Siggeaxe/DIY_Quadcopter/Quadcopter drone communication protocol.docx

# Quadcopter drone communication protocol

Each message from slave to master consists of two bytes where one decides the function

0b XXXX XXXX XXXX XXXX

Command byte Value Byte

Commands list

Command | Variable | Description
0000 0001 | PCOM | Lift power is set according to map(byte2 0, 256, 900, 2200);
0000 0010 | ref_x | Rotation around x axis (-128 128) degrees/s
0000 0011 | ref_y | Rotation around y axis (-128 128) degrees/s
0000 0100 | force_zero | Forces ref_x and ref_y to zero if byte2 is 1.
