Siggeaxe/DIY_Quadcopter/länkar/Modelering och Systemidentifiering/Autonomous Drone Racing Project Course.pdf

## Autonomous Drone Racing Project Course

## Quadrotor Introduction Handout

## 1. Overview

Quadrotors are flying vehicles that have a rigid frame with four independently controlled motors, as shown in Figure 1. By changing the motor speeds, we can make the quadrotor perform different maneuvers such as moving towards a specified position or performing a flip. As compared to conventional fixed-wing flying vehicles, quadrotors are more compact and can perform vertical takeoff and landing, which makes them suitable for a wide range of applications. Some example applications include search and rescue, industrial inspection, and entertainment.

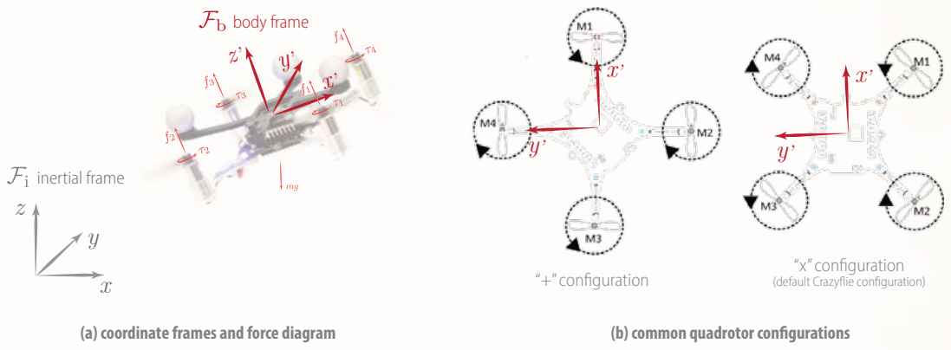
[picture p17: figure]

Figure 1: Illustration of a quadrotor: (a) A quadrotor is a flying vehicle equipped with a rigid frame and four motors that are controlled independently. Typically, two of the motors spin in the clockwise direction and two spin in the counterclockwise direction. Each motor generates a thrust f
i aligning with the axis of rotation and a torque τi about its axis of rotation. Different quadrotor maneuvers are realized by varying the speeds of the four independently controlled motors. As an example, hovering motion can be achieved by setting the motor speeds such that f
i = mg/4 for all
i = {1, 2, 3, 4}, where m is the mass of the quadrotor and g is the acceleration due to gravitation. Generally, the translational acceleration of the quadrotor is determined by the attitude of the quadrotor, which is in turn controlled via the individual motors. There are two essential coordinate frames pertinent to every quadrotor estimation, planning, and control framework: (i) the inertial frame or the “world frame” and (ii) the body frame that is fixed to the quadrotor. The translation and rotation of the body frame relative to the world frame together characterize the pose of the quadrotor that is estimated based on sensor measurements and is used for planning and control. (b) There are two common configurations or body frame conventions for a quadrotor. The “+” configuration aligns have its x and y axes aligned with the frame, while the “×” configuration offsets by 45◦
. From a mathematical point of view, there are no major differences between the two configurations. Practically, the latter could be preferable for certain cases (e.g., mounting a front-facing camera below the frame. The Crazyflie platform used in this course follows the “×” configuration for its onboard estimation and control algorithm implementations.

## 2. Quadrotor Dynamics

The motion of a quadrotor is fully driven by the four motors—two spinning clockwise and two spinning counterclockwise, as illustrated in Figure 1. Quadrotors are underactuated systems as it has six degrees of freedom but only four independent inputs. We briefly summarize the dynamics

Page 1 of 11 pages | last revised: April 9, 2024

of a quadrotor system in this section, which are divided into two parts: (i) motor dynamics and (ii) rigid body dynamics.

### 2.1 Motor Dynamics

Each motor is equipped with a propeller that is firmly attached to the motor’s shaft. As the motor rotates, the propeller produces a force, known as thrust fi
, that is aligned with the motor’s axis of rotation, as well as a reaction torque τi about the axis of rotation. The thrust and torque produced by each motor are determined by their respective characteristic curves, which are often identified empirically. A basic motor model takes the following form:

fi = ctΩ²
i
, | (1)

τi = cdΩ²

i + JmΩ˙
i
| {z }
inertia
moment
, | (2)

where Ωi denotes the motor rotational speed represented as revolutions per minute (RPM), ct and cd respectively are the lift and drag coefficients associated with the particular propeller, and Jm is the inertia coefficient. The inertia moment of the motor is often negligible; both motor thrust and torque are roughly proportional to Ω²
i

. The lift and drag coefficients of the default Crazyflie setup are 3.1582 × 10⁻¹⁰ N/RPM² and 7.9379 × 10⁻¹² Nm/RPM²
, respectively.
How do we regulate the speed of the motor? This is controlled by the pulse-width modulation (PWM). Intuitively, the PWM controls the average power delivered to the motor by varying the duration and frequency of switching on/off the voltage supply. For the DC motor used on the Crazyflie platform, we can relate the PWM signal µ and the RMP as follows:
Ωi = αµi + β, | (3)

where the PWM signal µi

is a 16-bit number between 0 and 65535, and α = 0.2685 and β = 4070.3 are two constants specific to the motor.

### 2.2 Rigid Body Dynamics

The motor thrust and torque collectively generate thrust forces and torques that enable different quadrotor maneuvers. The collective thrust generated by the motors is always aligned with the body z

′
-axis:

F =

4
∑

i=1

fi = ct

4
∑

i=1

Ω²
i
. | (4)

Following the “×” configuration defined in Figure 1, we can express the body torques as a function of the motor rotation rates as follows:

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
−cτxy | −cτxy | +cτxy | +cτxy
−cτxy | +cτxy | +cτxy | −cτxy
−cτz | +cτz | −cτz | +cτz

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
where cτxy = lct/

√
2 and cτz = cd and l is the arm length of the quadrotor (i.e., the distance from the centre to the motor shaft). Note that the reaction torque generated by individual motors is opposite to their rotation direction (Figure 1).
Page 2 of 11 pages | last revised: April 9, 2024

The collective thrust F and the body torque τ are the inputs to the rigid body dynamics of the quadrotor system. A continuous-time model of the quadrotor is

p˙ = v, | (6)
mv˙ = mg + Rf, | (7)
R˙ = RS(ω), | (8)
Jω˙ = Jω × ω + τ, | (9)

where p = [px, py, pz]

T and v = [vx, vy, vz]

T are the translational position and velocity of the center of mass (COM) of the quadrotor, R

i
b

is the rotation matrix from the body frame to the inertial frame, ω = [p, q,r]

T
is the body angular velocity, m is the mass of the quadrotor, J = diag(Jxx, Jyy, Jzz) is the inertia matrix, S(·) denotes the skew-symmetric matrix mapping of a vector, and g = [0, 0, −g]

T
is the gravitational force vector.
Note that, there are different ways of parametrizing the orientation of a quadrotor (or a rigid body in general). Euler angles and quaternions are two common parameterizations. The former is easier to interpret intuitively but has singularity issues, while the latter is easier to work with computationally but is an over-parametrization scheme. To facilitate the controller design discussion in the following section, we briefly review how the rotational dynamics can be expressed in terms of Euler angles; one could similarly express the rotational dynamics in quaternions.
The Euler angles refer to the roll ϕ, pitch θ, and yaw ψ angles, which respectively correspond to rotations about the x, y, and z axes. One can uniquely define a rotation matrix through these angles following a specified sequence of rotation. As an example, a Z-Y-X sequence (i.e., first rotating about the z axis by ψ, then about the y axis by θ, and lastly about the x axis by ϕ) results in the following rotation matrix from the inertial frame to the body frame:

R

b
i =
cos θ cos ψ | cos θ sin ψ | − sin θ
sin ϕ sin θ cos ψ − cos ϕ sin ψ sin ϕ sin θ sin ψ + cos ϕ cos ψ sin ϕ cos θ cos ϕ sin θ cos ψ + sin ϕ sin ψ cos ϕ sin θ sin ψ − sin ϕ cos ψ cos ϕ cos θ
- . (10)

Note that, the rotation matrix from the body frame to the inertial frame is R

i
b = (R

b
i

)

−1 = (R
b
i

)

T
We can relate the body angular velocity and the time-derivatives of Euler angles as follows:

p
q
r
- =
1 | 0 | − sin θ
0 | cos ϕ | sin ϕ cos θ
0 − sin ϕ cos ϕ cos θ
| | {z | }
W1

ϕ˙
˙θ
ψ˙

|{z}
ψ˙
= W1 ψ˙ , | (11)

ϕ˙
˙θ
ψ˙
- =
1 | sin ϕ tan θ | cos ϕ tan θ
0 | cos ϕ | − sin ϕ
0 sin ϕ/ cos θ cos ϕ/ cos θ
| | {z | }
W2

p
q
r

|{z}
ω

= W2 ω for θ ̸=

π
2
, | (12)

The rotational dynamics can then be written as

ψ¨ = W˙

2 ω + W2 ω˙ = W˙
2 ω + W2 J

−1
(Jω × ω + τ), | (13)

where ψ¨ = [ϕ¨,

¨θ, ψ¨]
T and ω = W1 ψ˙ .
Let u = [F, τx
′ , τy

′ , τz

′]

T be the input and x = [p

T
, v

T

, ψT

, ψ˙ T
]

T be the state. We can write the translational and rotational dynamics in the state-space model form:

x˙ = f(x, u). | (14)
Page 3 of 11 pages | last revised: April 9, 2024

One could also define u as the motor rotation rates [Ω²
1

, Ω²
2

, Ω²
3

, Ω²
4

]

T or the PWM signals
[µ
2/1, µ

2/2, µ

2/3, µ

2/4]

T
if the lower-level motor dynamics is of interest for the particular problem. The parameters for the Crazyflie platform are summarized in Table 1.

Table 1: Parameters of the Crazyflie platform.

mass (m) | 0.27 kg
arm length (l) | 42.0 × 10⁻³ m
moment of inertia (Jxx, Jyy, Jzz) | (1.395 × 10⁻⁵

, 1.436 × 10⁻⁵

, 2.173 × 10⁻⁵
) kg m²

### 2.3 So, how do things fit together?

The PWM of individual motors regulates their rotational speeds, and the motor RPMs determine the thrust and reaction torque produced. Variations in thrust and torque among individual motors result in body torques, influencing the quadrotor’s attitude. The attitude and collective thrust of the quadrotor together determine the direction and magnitude of translational acceleration, respectively, which induces translational motion.

## 3. Quadrotor Control

We consider a trajectory-tracking problem and present a typical controller to demonstrate the idea. The trajectory consists of [pdes, ψdes] and is often given by a trajectory generator to realize a higher-level objective (e.g., navigating through an environment).
The controller design of the quadrotor system addresses the question: how do we go from the position trajectory to the low-level motor commands such that the COM of the quadrotor accurately follows the desired trajectory? One approach is to break the problem into three subproblems, resulting in a nested control architecture (Figure 2). There are three key components in the overall control system:
1. High-level position control: Mapping desired position (and optionally yaw) trajectories to desired attitude (i.e., roll, pitch, and yaw angles) and desired collective thrust
2. Mid-level attitude control: Mapping desired attitude to desired body torques
3. Low-level motor control: Computing motor speeds based on desired body torques and desired collective thrust
A default controller equipped onboard the Crazyflie is the Mellinger controller (Mellinger and Kumar, 2011). We summarize the key equations here; you are encouraged to check out the onboard implementation of the Crazyflie platform to better understand how it works.

### 3.1 Position Control

The desired collective thrust and attitude are computed to drive the position error of the quadrotor to zero. We define the position error as

ep = p − pdes. | (15)

A possible way for computing the desired translational acceleration in the inertial frame is based on a PD control law:

fdes = −kpep − kde˙ p
| | {z | }
| feedback
− | mg
|{z}
feedforward
, | (16)
Page 4 of 11 pages | last revised: April 9, 2024

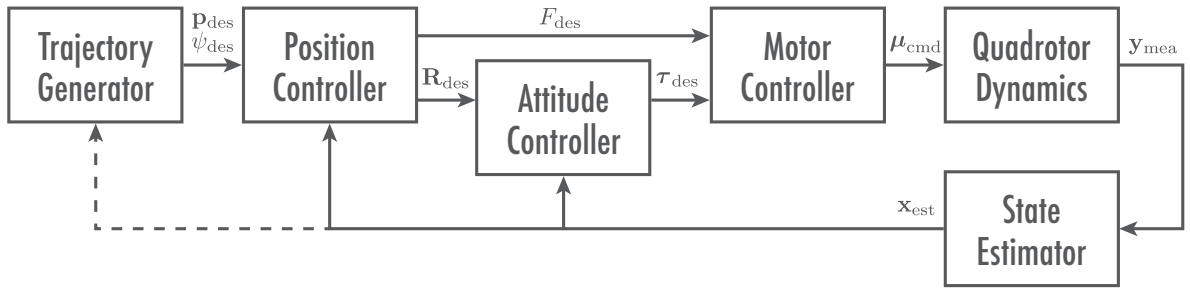
[picture p18: figure]
Trajectory Generator; Position; Controller; Attitude; State Estimator; Quadrotor Dynamics; Motor Controller

Figure 2: Block diagram of a typical quadrotor system: The trajectory generator provides the desired position and yaw trajectories to fulfill a high-level task. The controller can be decomposed into three levels: (i) the position controller computes the desired collective thrust and attitude to minimize the position and yaw error, (ii) the attitude controller computes the desired body torques based on the attitude error, and (iii) the motor controller then computes motor commands to realize the desired collective thrust and body torques. A state estimator is used to bookkeep the sensor measurements (e.g., IMU measurements, motion capture system measurements, ultra-wideband signals, RGB-D camera images) and provides consistent estimates of the quadrotor’s full state that are fed back to the controllers and optionally the trajectory generator.

where kp > 0 and kd > 0 are the PD gains. The desired collective thrust (defining the desired magnitude of acceleration) is the projection of fdes to the body z

′ axis:

Fdes = (fdes)

T
z

′
(17)

The desired attitude (defining the desired direction of acceleration and accounting for the desired yaw angle) can be written as a rotation matrix as follows:

Rdes =

x

′
des y

′
des z

′
des
, | (18)

where

z

′
des =

fdes
||fdes||, | (19)

y

′
des =

z

′
des × ndes
||z

′

des × ndes|| with ndes =

cos ψdes
sin ψdes
0
- , and | (20)

x

′
des = y

′
des × z

′
des. | (21)

### 3.2 Attitude Control

The attitude controller computes the desired moments to bring the actual rotation Ract close to the desired rotation Rdes. The orientation error is defined as

εR =

1
2
R

T
desRact − R

T

actRdes∨
, | (22)
where “∨” is the vee operator that maps elements of SO(3) to R³ | . The angular velocity error is
defined as follows:
εω = ωact − ωdes. | (23)

Note that, the desired angular velocity ωdes should be defined such that εω is consistent with the rotation error εR. We can alternatively set it to zero, but this would typically lead to poorer tracking performance. The desired body torques can be similarly computed based on a PD scheme:

τdes = −kRεR − kωεω, | (24)

where kR and kω are diagonal matrices with positive gains.

Page 5 of 11 pages | last revised: April 9, 2024

### 3.3 Motor Control

Given Fdes and τdes, we can compute the corresponding desired motor rates. This step is really reversing the maps defined in (4) and (5) by solving for Ωi
. The desired motor rates for given Fdes and τdes can be computed as follows:

Ω²
1,des
Ω²
2,des
Ω²
3,des
Ω²
4,des

=

1
4

1/ct | −1/cτxy | −1/cτxy | −1/cτz
1/ct | −1/cτxy | 1/cτxy | 1/cτz
1/ct | 1/cτxy | 1/cτxy | −1/cτz
1/ct | 1/cτxy | −1/cτxy | 1/cτz

Fdes

τdes
, | (25)

where cτxy = lct/

√
2 and cτz = cd
The PWMs of the individual motors are computed by inverting the map in (3):

µi,cmd = α

−1
(Ωi,des − β). | (26)

## 4. Smooth Trajectory Generation

The trajectories are often required to be sufficiently smooth and satisfy a set of constraints to be feasible for a quadrotor to track. There are various methods to generate trajectories for a quadrotor system; we present one position trajectory generation formulation that is adapted based on (Mellinger and Kumar, 2011). The desired yaw angle can be often defined in a decoupled manner. For a quadrotor equipped with an onboard camera for mapping the environment, the desired yaw angle could be, for instance, designed to maximize the information gain.
The desired position trajectories px,des, py,des, and pz,des are respectively parametrized as splines or piecewise polynomials. The minimum-derivative trajectory optimization problem is to minimize the objective:

min Z t1

t0

||T

(r)
1

(t)||²
dt +

Z t2

t1

||T

(r)
2

(t)||²
dt + · · · +

# Z tS

tS−1

||T

(r)
S

(t)||²
dt
| | {z | }
| ≜J

(27)

subjected to the spline continuity constraints (i.e., continuity of the value and higher derivatives at endpoints), where Ts(t) = ∑

N
n=0 ps,nt

n
for s = {1, 2, ..., S} are S segments of Nth-order polynomials composing the spline, and the superscript (r) denotes the rth time-derivative. In the discussion below, following derivations similar to (Richter et al., 2016; Mellinger and Kumar, 2011), we show that this objective can be written in a quadratic form and the overall optimization can be formulated as a quadratic program (QP).

### 4.1 Objective Function in Quadratic Form

We first show that the minimum-derivative objective associated with each polynomial segment Ts(t) can be written in the following quadratic form:

Js =

# Z ts

ts−1

||T

(r)
s (t)||²
dt = p

T
s Qsps
, | (28)

where Js denotes the objective function associated with the sth polynomial, ps are the coefficients of the polynomial in ascending order, and Qs ∈ R⁽N+1)×(N+1)
is the Hessian to be derived. Note that the objective function for the overall spline can be written as

J =

S
∑

s=1

p

T
s Qsps = P
TQP, | (29)
Page 6 of 11 pages | last revised: April 9, 2024

where P = [p

T
1

, p

T
2

, ..., p

T
S

]

T
is the stack of the coefficients for all S polynomial segments and Q = blockdiag(Q1, Q2, ..., QS) is the augmentation of Hessians. In the derivations below, we focus on the objective function for one of the segments Js

▷ Objective function: The objective function is

Js =

# Z ts

ts−1

||T

(r)
s (t)||²
dt =

# Z ts

ts−1

d

r
dtr

N
∑

n=0

ps,nt

n

2
dt =

# Z ts

ts−1

I(t) dt, | (30)

where I(t) =

d

r
dtr ∑

N
n=0 ps,nt

n

2
=
d

r
dtr ∑

N
n=0 ps,nt

n

2
denotes the integrand in the minimum-derivative objective function.
▷ Derivative: The rth derivative of the polynomial can be written as

d

r
dtr

N
∑

n=0

ps,nt

n =

N
∑n=r
ps,n [n(n − 1)· · ·(n − r + 1)] t

n−r =

N
∑n=r

"
ps,n

r−1
∏m=0
n − m

!
t

n−r

. (31)

Note that the objective function drops the dependencies on the first r − 1 coefficients; these coefficients play a role only in the constraints. In other words, the magnitudes of the higher-order coefficients are penalized with this objective, which enforces smoothness.
▷ Square of polynomials: After obtaining the rth derivative, the next operation in (30) to consider is the square of the polynomial (derivative, in fact). There are different ways of calculating the square of polynomials (e.g., in (Richter et al., 2016), it is written as a convolution and the Hessian is then calculated by taking derivatives of the convolution). Here, we try to take a different approach, where we write out the quadratic form directly (without the need to take derivatives twice afterwards).
We first note that the square of a polynomial ρ(ξ) = ∑

K
k=0

θkξ

k
(swapped notations to Greek letters to avoid confusion) can be written as

ρ(ξ) =

K
∑

k=0

θkξ

k

!2
(32)

=

θ0 | θ1 | · · · θK

ξ

0
ξ

1
- · · ξ

K
ξ

1
- · · | ξ
K | ξ

K+1

ξ

K ξ

K+1
- · · ξ

2K

| | {z | }
≜ Ξ

θ0
θ1
θK

| {z }
≜ θ

(33)

= θ

TΞθ. | (34)

For our case, where the square is raised to the derivative of the polynomial, we can apply the above quadratic form translation by only considering the elements in the bottom square block from indices r to N (since the summation is from n = r to n = N in (31) and the coefficient vector contains the coefficients from n = 0 to n = N).
Here are the details. We write the square of the polynomial in (31) (which is also the integrand
Page 7 of 11 pages | last revised: April 9, 2024

of the objective function in (30)) as

I(t) =

N
∑n=r

"
ps,n

r−1
∏m=0
n − m

!
t

n−r

#!2

(35)

= pe

T

t

0
t

1
- · · t

N−r
t

1
- · · t

N−r
t

N−r+1

t

N−r
t

N−r+1
- · · t

2(N−r)

| | {z | }
| ≜ Me (t)
pe, | (36)

where pe =

h
ps,r
∏

r−1
m=0

r − m

, ps,r+1
∏

r−1
m=0

r + 1 − m

, ..., ps,N
∏

r−1
m=0 N − m

iT
. Note
that the series multiplied by the polynomial coefficients are constants; for convenience, we define

c(q) =

r−1
∏m=0
q − m, | (37)

where r is the order of the derivative we are taking in (31). We define a matrix C ∈
R⁽N−r+1)×(N+1)

C =

0 · · · 0 | c(r) | 0 | · · · | 0
0 · · · 0 | 0 | c(r + 1) · · · | 0
0 · · · 0 | 0 | 0 | · · · c(N)

=

h
0(N−r+1)×r Ce

i
, | (38)

and rewrite (36) as

I(t) = p

T
s C
TMe (t)Cps | (39)

= p

T
s M(t)ps
, | (40)

where the substitution pe = Cps

is made and M(t) = C

TMe (t)C.

▷ Integration: Given the quadratic form of the integrand in (40), we can then evaluate the integration in the minimum-derivative objective function in (30) between two given times
ts−1 and ts

. We note that, in the quadratic form in (40), the only time-dependent terms come from M(t), which are summarized in the matrix Me (t). The operations of the quadratic form are equivalent to a set of summations over the non-zero entries of M(t) which comes down to the elements of Me (t). The integration of the quadratic expression I(t) can be then evaluated and written as below

Js =

# Z ts

ts−1

I(t) dt | (41)

=

# Z ts

ts−1

p

T
s C
TMe (t)Cps dt | (42)

= p

T
s Qsps
, | (43)

where

Qs = C

TQesC =

"
0r×r | 0r×(N−r+1)
0(N−r+1)×r | CeTQesCe
, | (44)
Page 8 of 11 pages | last revised: April 9, 2024

### 0 are zero matrices with dimensions indicated by the corresponding subscripts, and Qes

contains the element-wise integrations of Me (t) from ts−1 to ts

Qes =

ts − ts−1

t

2
s−t

2
s−1
2
- · ·

t

N−r+1
s −t

N−r+1
s−1
N−r+1
t

2
s−t

2
s−1
2
- · ·

t

N−r+1
s −t

N−r+1
s−1
N−r+1

t

N−r+2
s −t

N−r+2
s−1
N−r+2

t

N−r+1
s −t

N−r+1
s−1
N−r+1

t

N−r+2
s −t

N−r+2
s−1
N−r+2
- · ·

t

2(N−r)+1
s | −t

2(N−r)+1
s−1
2(N−r)+1

. | (45)

Continuity as Equality Constraints. The position trajectories are splines and C

r
continuities can
be enforced at the endpoints to ensure feasibility for tracking. Similar to the objective function derivation, we consider one polynomial segment indexed with s. The rth derivative of the polynomial at the endpoints can be written as

Asrtps =

0 · · · 0 c(r) c(r + 1)t · · · c(N)t

N−r
ps
, | (46)

where t = {ts−1, ts} is the time at the end point. A side note on the notation: the subscripts of the matrix A are s denoting the segment index, r denoting the rth derivative of the polynomial, and t denoting the starting or the terminal endpoint. For each polynomial segment s, we can encode the continuity constraints as follows:

Asps = bs
, | (47)

where

As =

As0ts−1
As1ts−1

Asrmaxts−1
As0ts
As1ts

Asrmaxts

and bs =

T

(0)
s (ts−1)
T

(1)
s (ts−1)
T

(rmax)
s (ts−1)
T

(0)
s (ts)
T

(1)
s (ts)
T

(rmax)
s (ts)

. | (48)

### 4.2 The Smooth Trajectory Generation QP

The minimum-derivative trajectory optimization problem is overall a QP that can be solved efficiently:

min
p

S
∑

s=1

p

T
s Qsps
subject to | Asps = bs | for s = {1, 2, ..., S},

(49)

where ps contains the coefficients of the sth polynomial segment (in the ascending order), Qs is the
Hessian matrix defined in (44), and the pairs (As
| | , bs) set continuity constraints on the endpoints
of the polynomials composing the spline. One may optionally introduce additional constraints on the spline trajectories or their higher derivatives to account for the physical constraints of the quadrotor and the operating environment.
Page 9 of 11 pages | last revised: April 9, 2024

## 5. Further Reading

Drone Racing

[1] E. Kaufmann, L. Bauersfeld, A. Loquercio, M. Muller, V. Koltun, and D. Scaramuzza, ¨ “Champion-level drone racing using deep reinforcement learning,” Nature, vol. 620, no. 7976, pp. 982–987, 2023. [pdf] (https://www.nature.com/articles/s41586-023-06419-4)
[2] D. Hanover, A. Loquercio, L. Bauersfeld, A. Romero, R. Penicka, Y. Song, G. Cioffi,
E. Kaufmann, and D. Scaramuzza, “Autonomous drone racing: A survey,” 2023. [pdf] (https://rpg.ifi.uzh.ch/docs/Arxiv24_Romero.pdf)

General Quadrotor Modeling, Planning, and Control

[1] D. Mellinger and V. Kumar, “Minimum snap trajectory generation and control for quadrotors,” in Proc. of the IEEE International Conference on Robotics and Automation (ICRA), 2011, pp. 2520–2525. [pdf] (https://1drv.ms/b/s!AnKwjI86SDWmhboxcIjst3bHjY3qaQ?e=b567Zp)
[2] C. Powers, D. Mellinger, and V. Kumar, “Quadrotor kinematics and dynamics,” in Handbook of Unmanned Aerial Vehicles. Springer, 2015, ch. 16, pp. 307–327. [pdf] (https://1drv.ms/b/s!AnKwjI86SDWmhboyNGuAEXuU2Q5ODQ?e=nucRyh)

Crazyflie Modeling, Planning, and Control

[1] C. Luis and J. L. Ny, “Design of a trajectory tracking controller for a nanoquadcopter,” arXiv preprint arXiv:1608.05786, 2016, Technical Report, Mobile Robotics and Autonomous Systems Laboratory, Polytechnique Montreal. [pdf] (https://arxiv.org/pdf/1608.05786.pdf)
[2] C. E. Luis, M. Vukosavljev, and A. P. Schoellig, “Online trajectory generation with distributed model predictive control for multi-robot motion planning,” IEEE Robotics and Automation Letters (RA-L), vol. 5, no. 2, pp. 604–611, 2020. [pdf] (https://arxiv.org/pdf/1909.05150.pdf)
[3] S. Teetaert, W. Zhao, N. Xinyuan, H. Zahir, H. Leong, M. Hidalgo, G. Puga, T. Lorente,
N. Espinosa, J. A. D. Carrasco et al., “A remote sim2real aerial competition: Fostering reproducibility and solutions’ diversity in robotics challenges,” arXiv preprint arXiv:2308.16743, 2023, IROS 2022 Safe Robot Learning Competition. [pdf] (https://arxiv.org/pdf/2308.16743.pdf)

Learning and Adaptation

[1] K. Pereida and A. P. Schoellig, “Adaptive model predictive control for high-accuracy trajectory tracking in changing conditions,” in Proc. of the IEEE/RSJ International Conference on Intelligent Robots and Systems (IROS), 2018, pp. 7831–7837. [pdf] (https://arxiv.org/pdf/1807.05290.pdf)
[2] Z. Wu, S. Cheng, P. Zhao, A. Gahlawat, K. A. Ackerman, A. Lakshmanan, C. Yang, J. Yu, and N. Hovakimyan, “L1 quad: L1 adaptive augmentation of geometric control for agile quadrotors with performance guarantees,” arXiv preprint arXiv:2302.07208, 2023. [pdf] (https://arxiv.org/pdf/2302.07208.pdf)
[3] A. P. Schoellig, F. L. Mueller, and R. D’andrea, “Optimization-based iterative learning for precise quadrocopter trajectory tracking,” Autonomous Robots, vol. 33, pp. 103–127, 2012. [pdf] (https://www.research-collection.ethz.ch/bitstream/handle/20.500.11850/50326/2/10514_2012_Article_9283.pdf)
[4] M. Greeff and A. P. Schoellig, “Flatness-based model predictive control for quadrotor trajectory tracking,” in 2018 IEEE/RSJ International Conference on Intelligent Robots and Systems (IROS), 2018, pp. 6740–6745. [pdf] (https://www.dynsyslab.org/wp-content/papercite-data/pdf/greeff-iros18.pdf)
[5] S. Zhou, M. K. Helwa, and A. P. Schoellig, “Deep neural networks as add-on modules for enhancing robot performance in impromptu trajectory tracking,” The International Journal of Robotics Research, vol. 39, no. 12, pp. 1397–1418, 2020. [pdf] (https://www.dynsyslab.org/wp-content/papercite-data/pdf/zhou-ijrr20.pdf)
Page 10 of 11 pages | last revised: April 9, 2024

## References

D. Mellinger and V. Kumar, “Minimum snap trajectory generation and control for quadrotors,” in Proc. of the IEEE International Conference on Robotics and Automation (ICRA), 2011, pp. 2520–2525.
C. Richter, A. Bry, and N. Roy, “Polynomial trajectory planning for aggressive quadrotor flight in dense indoor environments,” in Robotics Research. Springer, 2016, pp. 649–666.
E. Kaufmann, L. Bauersfeld, A. Loquercio, M. Muller, V. Koltun, and D. Scaramuzza, “Champion- ¨ level drone racing using deep reinforcement learning,” Nature, vol. 620, no. 7976, pp. 982–987, 2023.
D. Hanover, A. Loquercio, L. Bauersfeld, A. Romero, R. Penicka, Y. Song, G. Cioffi, E. Kaufmann, and D. Scaramuzza, “Autonomous drone racing: A survey,” 2023.
C. Powers, D. Mellinger, and V. Kumar, “Quadrotor kinematics and dynamics,” in Handbook of Unmanned Aerial Vehicles. Springer, 2015, ch. 16, pp. 307–327.
C. Luis and J. L. Ny, “Design of a trajectory tracking controller for a nanoquadcopter,” arXiv preprint arXiv:1608.05786, 2016, Technical Report, Mobile Robotics and Autonomous Systems Laboratory, Polytechnique Montreal.
C. E. Luis, M. Vukosavljev, and A. P. Schoellig, “Online trajectory generation with distributed model predictive control for multi-robot motion planning,” IEEE Robotics and Automation Letters (RA-L), vol. 5, no. 2, pp. 604–611, 2020.
S. Teetaert, W. Zhao, N. Xinyuan, H. Zahir, H. Leong, M. Hidalgo, G. Puga, T. Lorente, N. Espinosa,
J. A. D. Carrasco et al., “A remote sim2real aerial competition: Fostering reproducibility and solutions’ diversity in robotics challenges,” arXiv preprint arXiv:2308.16743, 2023, IROS 2022 Safe Robot Learning Competition.
K. Pereida and A. P. Schoellig, “Adaptive model predictive control for high-accuracy trajectory tracking in changing conditions,” in Proc. of the IEEE/RSJ International Conference on Intelligent Robots and Systems (IROS), 2018, pp. 7831–7837.
Z. Wu, S. Cheng, P. Zhao, A. Gahlawat, K. A. Ackerman, A. Lakshmanan, C. Yang, J. Yu, and
N. Hovakimyan, “L1 quad: L1 adaptive augmentation of geometric control for agile quadrotors with performance guarantees,” arXiv preprint arXiv:2302.07208, 2023.
A. P. Schoellig, F. L. Mueller, and R. D’andrea, “Optimization-based iterative learning for precise quadrocopter trajectory tracking,” Autonomous Robots, vol. 33, pp. 103–127, 2012.
M. Greeff and A. P. Schoellig, “Flatness-based model predictive control for quadrotor trajectory tracking,” in 2018 IEEE/RSJ International Conference on Intelligent Robots and Systems (IROS), 2018, pp. 6740–6745.
S. Zhou, M. K. Helwa, and A. P. Schoellig, “Deep neural networks as add-on modules for enhancing robot performance in impromptu trajectory tracking,” The International Journal of Robotics Research, vol. 39, no. 12, pp. 1397–1418, 2020.
Page 11 of 11 pages | last revised: April 9, 2024
