Siggeaxe/DIY_Quadcopter/Bilder/Period 1/carcontroller-DESKTOP-HCOR222.jpg

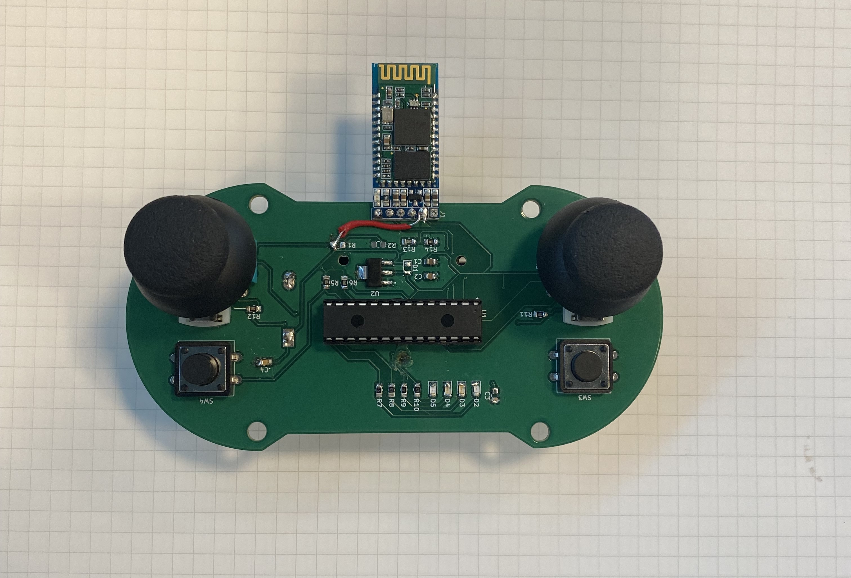
Bilder/Period 1/carcontroller-DESKTOP-HCOR222.jpg
