Siggeaxe/DIY_Quadcopter/Bilder/Period 1/carcontroller.jpg

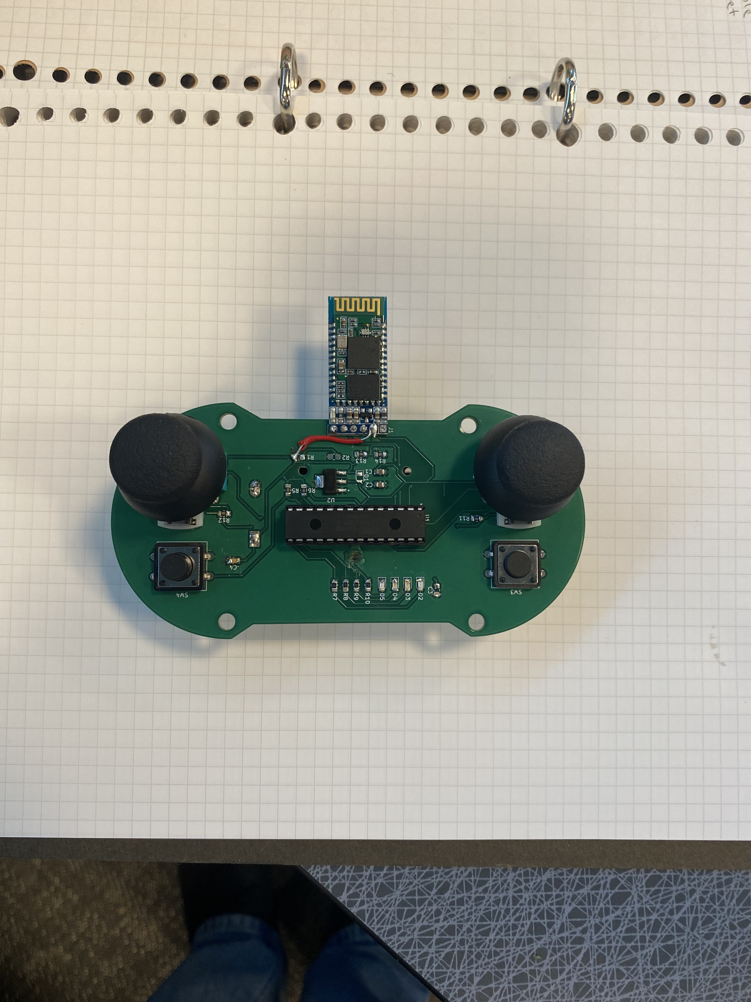
Bilder/Period 1/carcontroller.jpg
