Siggeaxe/DIY_Quadcopter/Bilder/Period 1/drone hovering.png

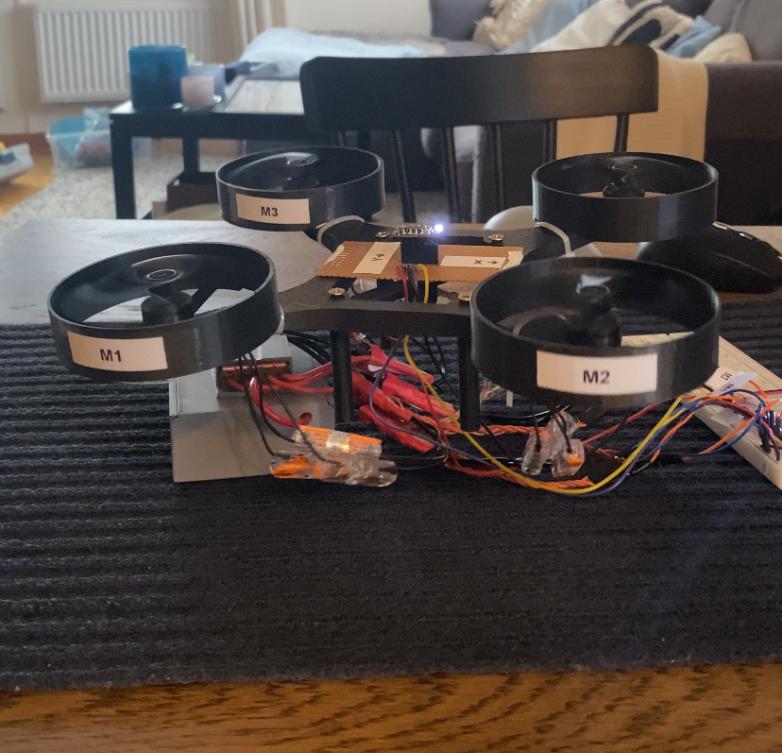
Bilder/Period 1/drone hovering.png
