Siggeaxe/DIY_Quadcopter/Bilder/Period 1/drone model simple - kopia.png

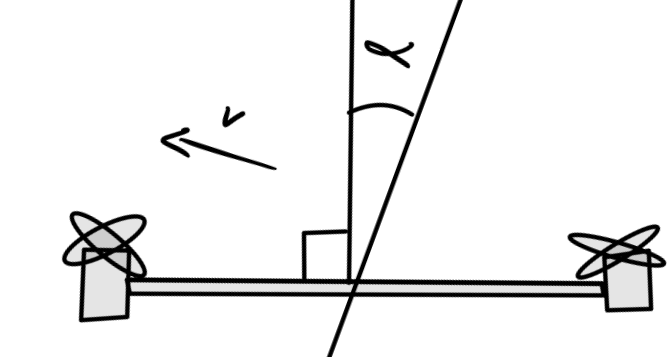
Bilder/Period 1/drone model simple - kopia.png
