Siggeaxe/DIY_Quadcopter/Bilder/Period 1/drone model simple simple.png

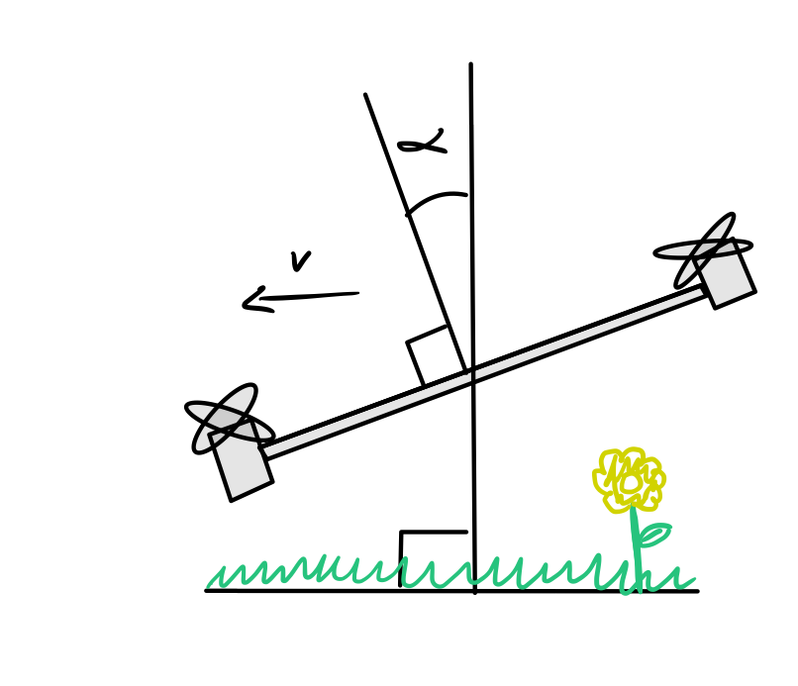
Bilder/Period 1/drone model simple simple.png
