Siggeaxe/DIY_Quadcopter/Bilder/Period 1/drone model simple.png

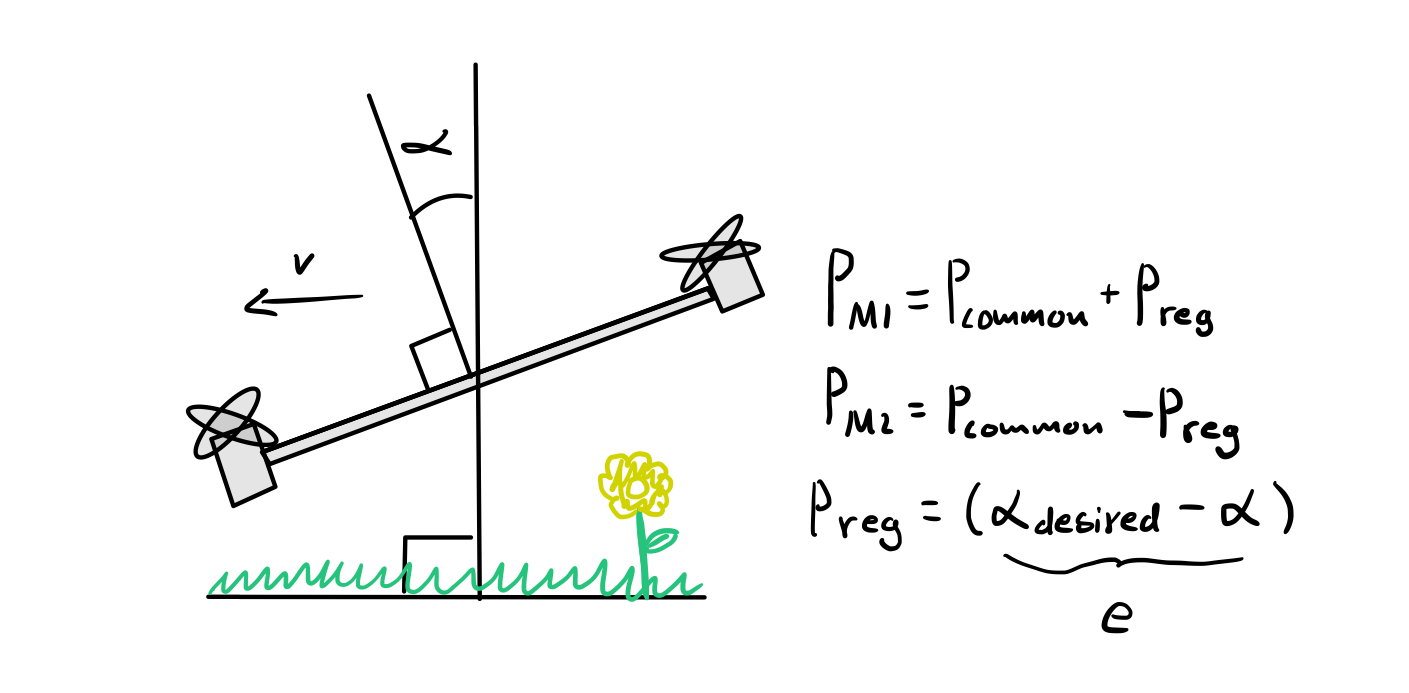
Bilder/Period 1/drone model simple.png
