Siggeaxe/DIY_Quadcopter/Bilder/Period 1/drone model.png

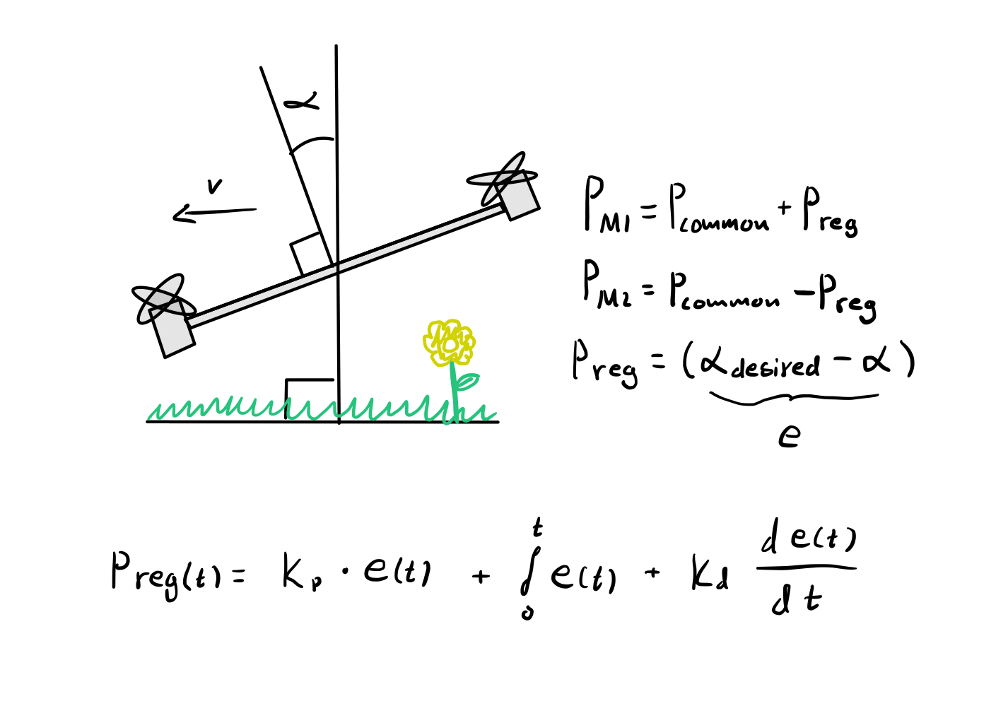
Bilder/Period 1/drone model.png
