Siggeaxe/DIY_Quadcopter/Bilder/Period 1/Drone remote schematic.png

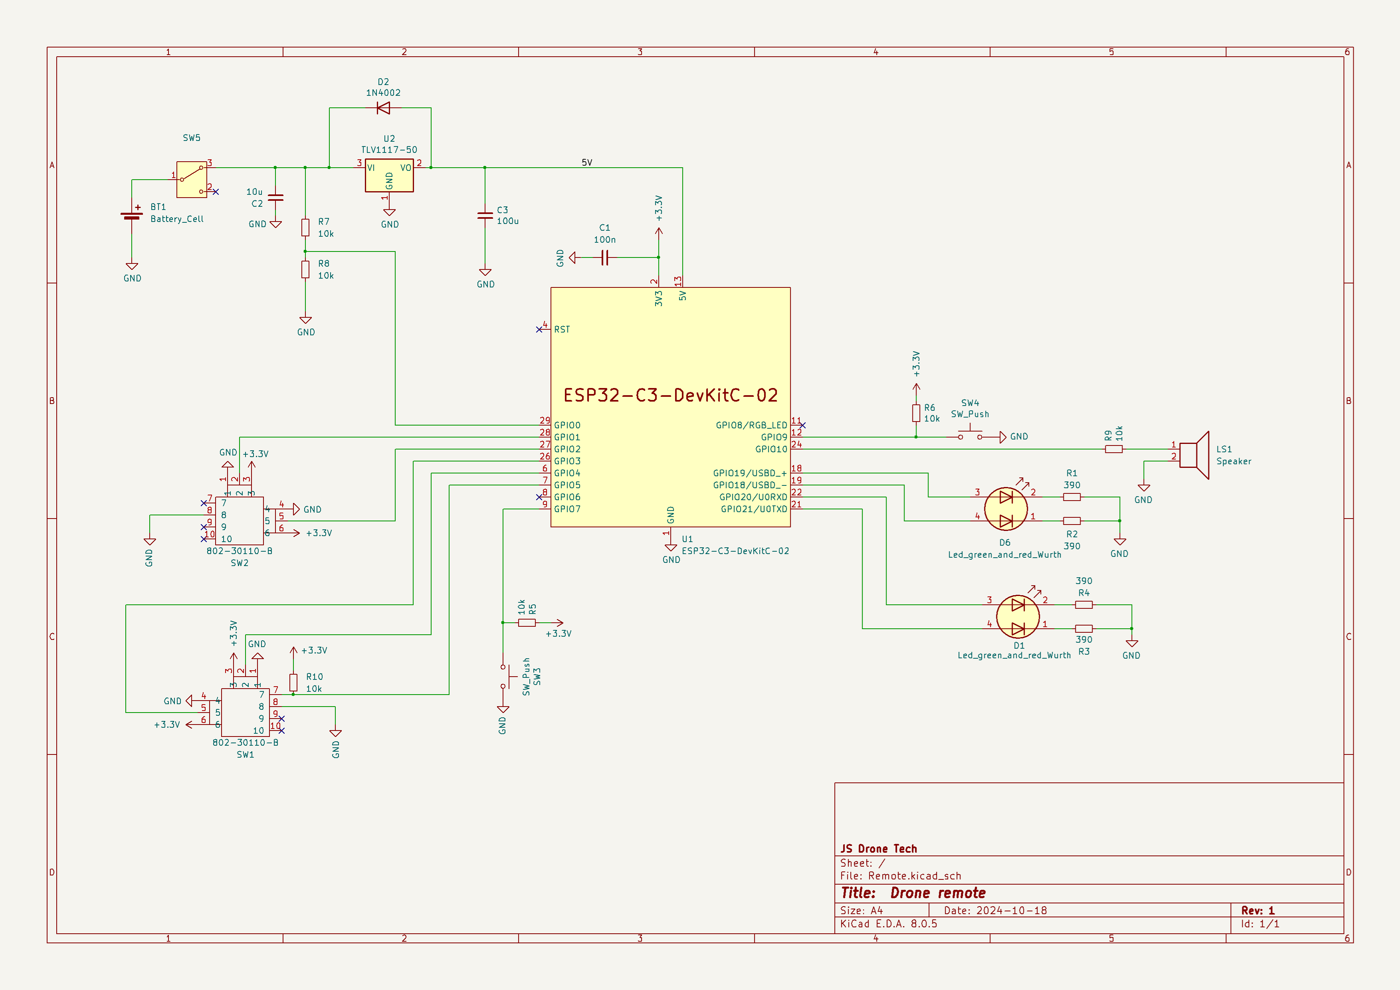
Bilder/Period 1/Drone remote schematic.png
