Siggeaxe/DIY_Quadcopter/Bilder/Period 1/Drönare Blockschema-1.jpg

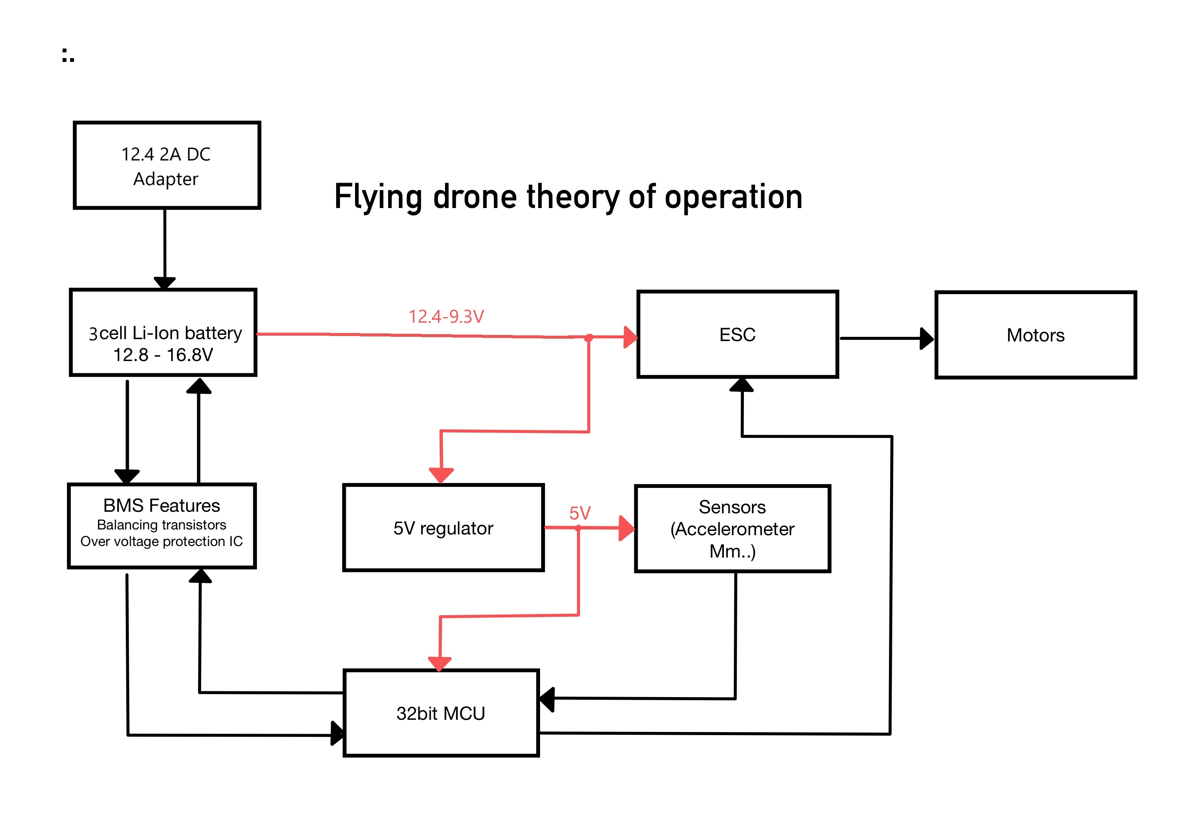
Bilder/Period 1/Drönare Blockschema-1.jpg
