Siggeaxe/DIY_Quadcopter/Bilder/Period 1/IMG_0003.JPG

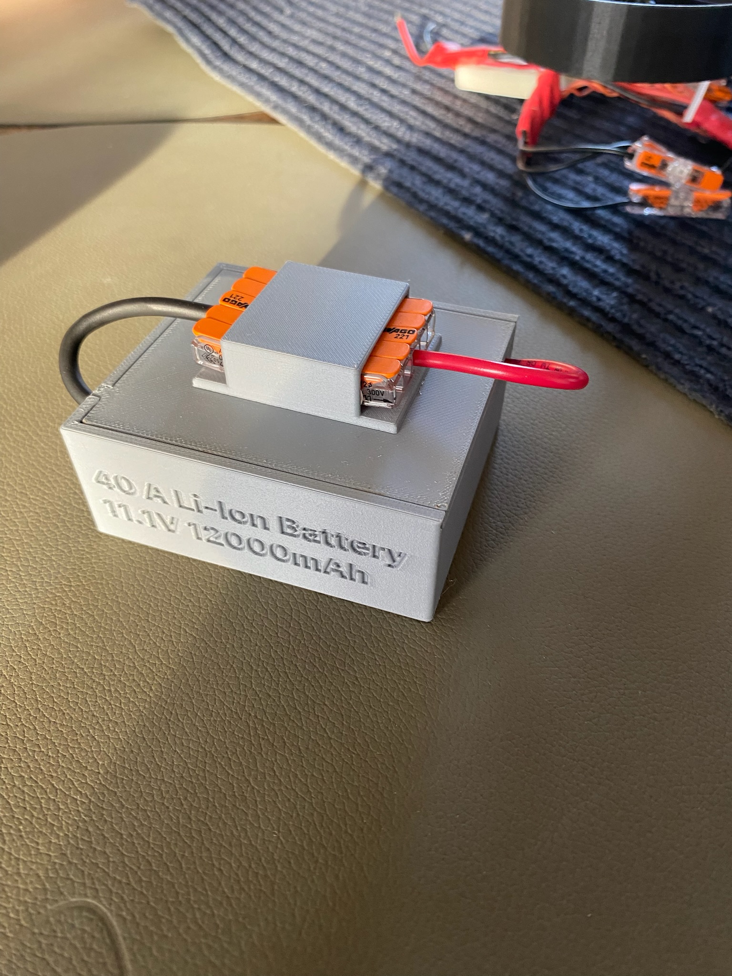
Bilder/Period 1/IMG_0003.JPG
