Siggeaxe/DIY_Quadcopter/Bilder/Period 1/IMG_0004.JPG

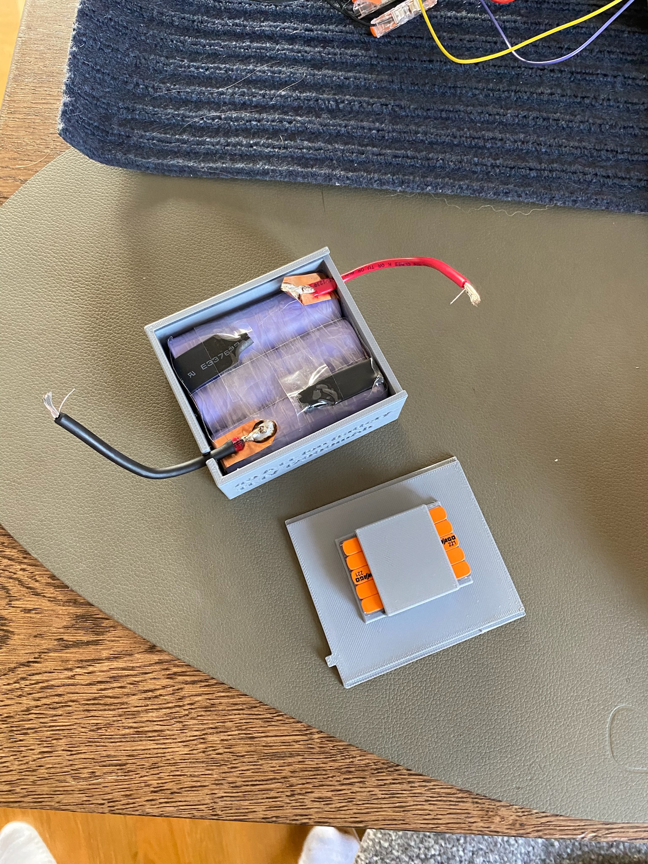
Bilder/Period 1/IMG_0004.JPG
