Siggeaxe/DIY_Quadcopter/Bilder/Period 1/IMG_0005.JPG

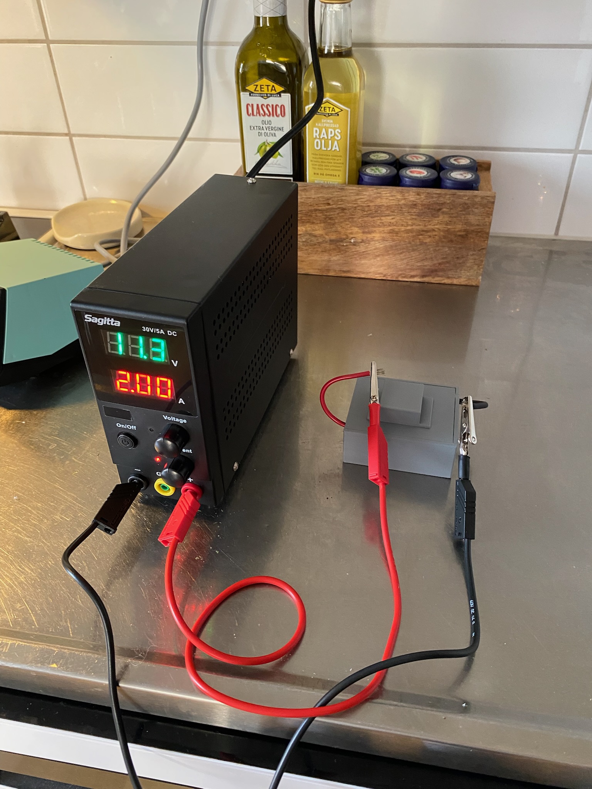
Bilder/Period 1/IMG_0005.JPG
