Siggeaxe/DIY_Quadcopter/Bilder/Period 1/IMG_0009.JPG

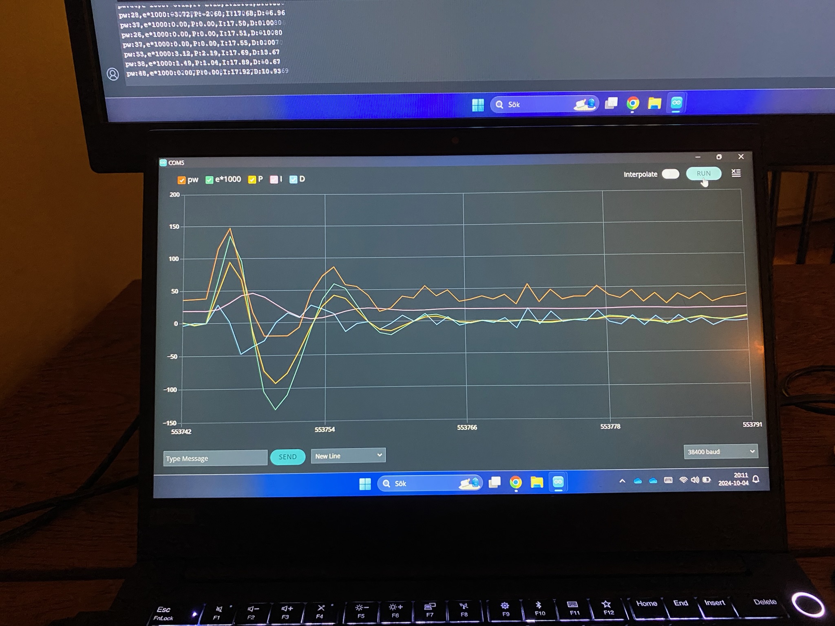
Bilder/Period 1/IMG_0009.JPG
