Siggeaxe/DIY_Quadcopter/Bilder/Period 1/IMG_0010.JPG

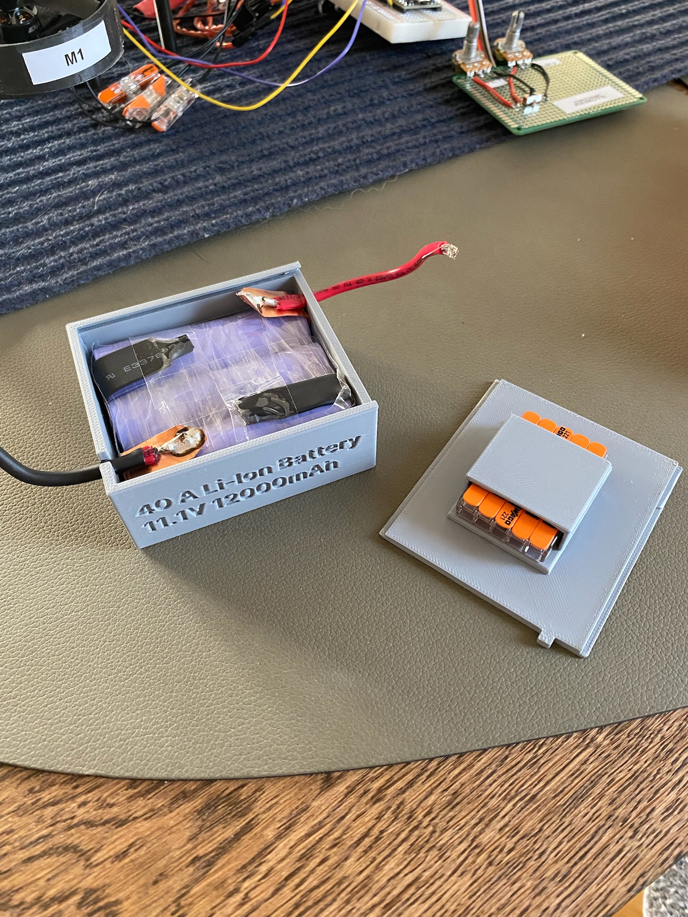
Bilder/Period 1/IMG_0010.JPG
