Siggeaxe/DIY_Quadcopter/Bilder/Period 1/IMG_0011.JPG

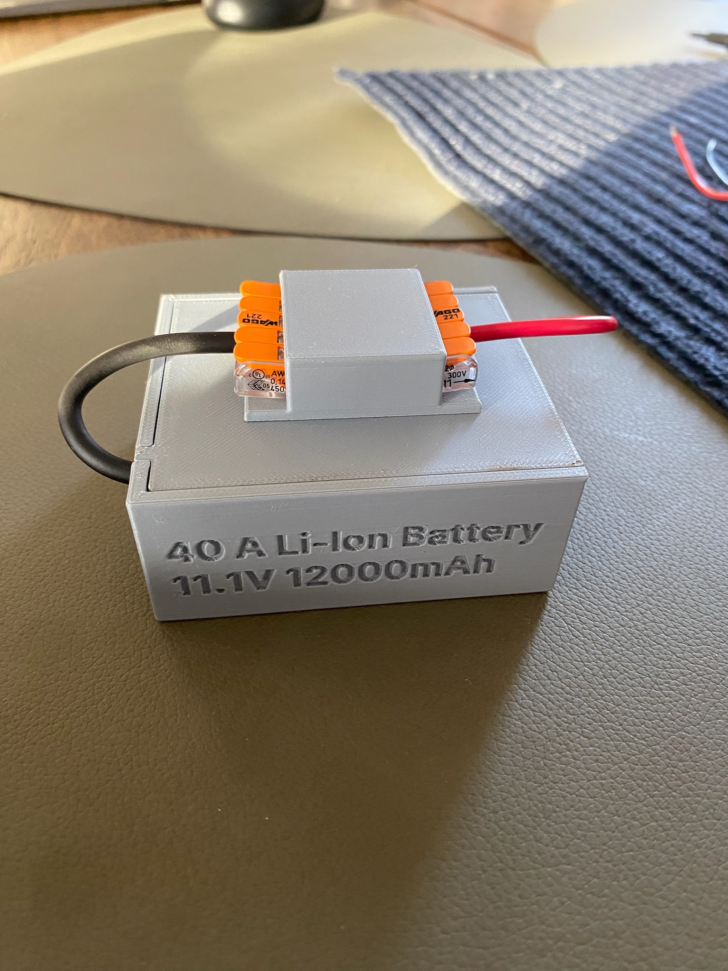
Bilder/Period 1/IMG_0011.JPG
