Siggeaxe/DIY_Quadcopter/Bilder/Period 1/IMG_0014.JPG

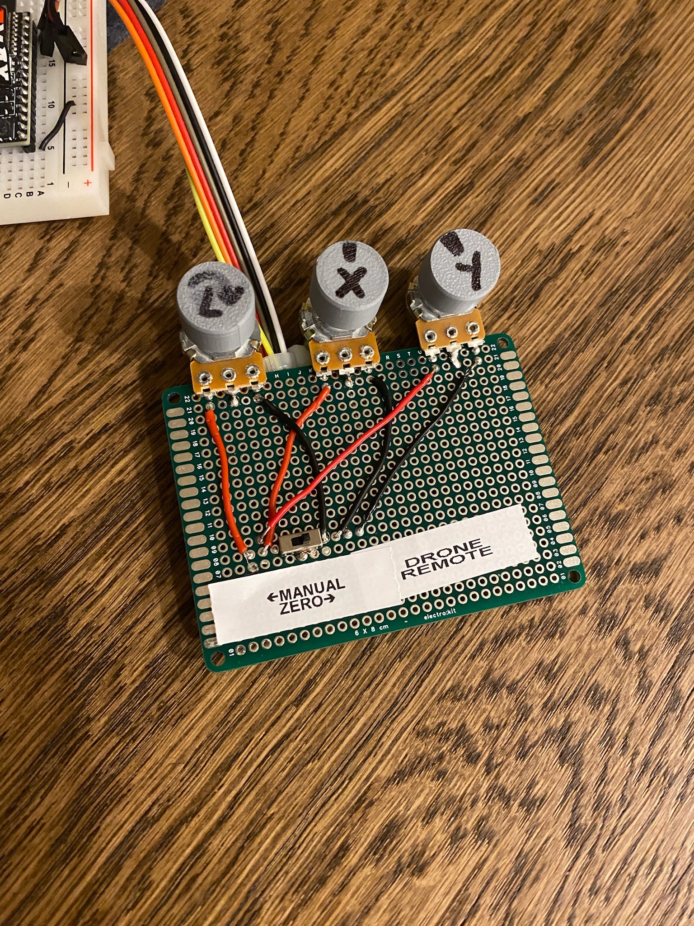
Bilder/Period 1/IMG_0014.JPG
