Siggeaxe/DIY_Quadcopter/Bilder/Period 1/IMG_3495.JPG

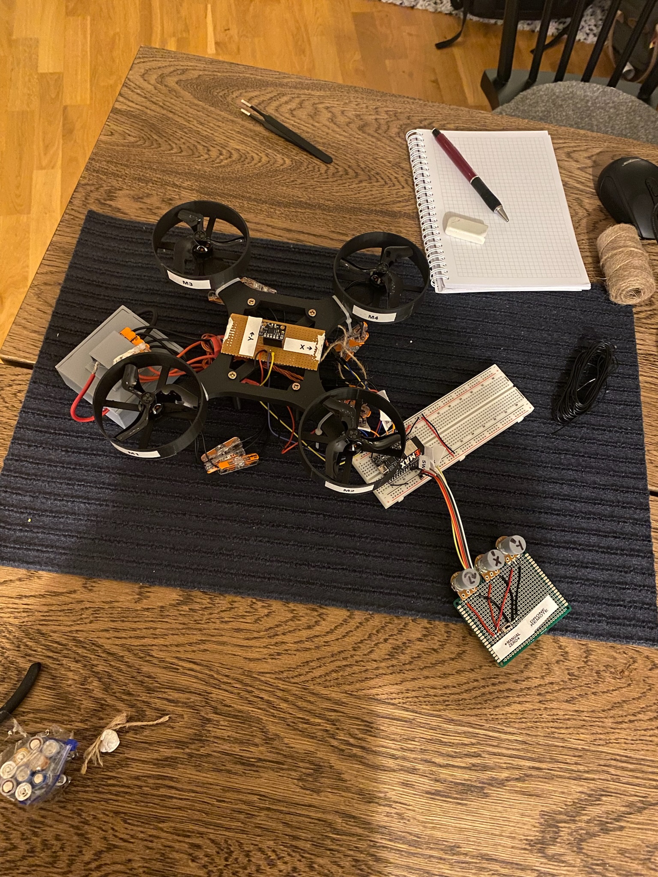
Bilder/Period 1/IMG_3495.JPG
