Siggeaxe/DIY_Quadcopter/Bilder/Period 1/IMG_3497.JPG

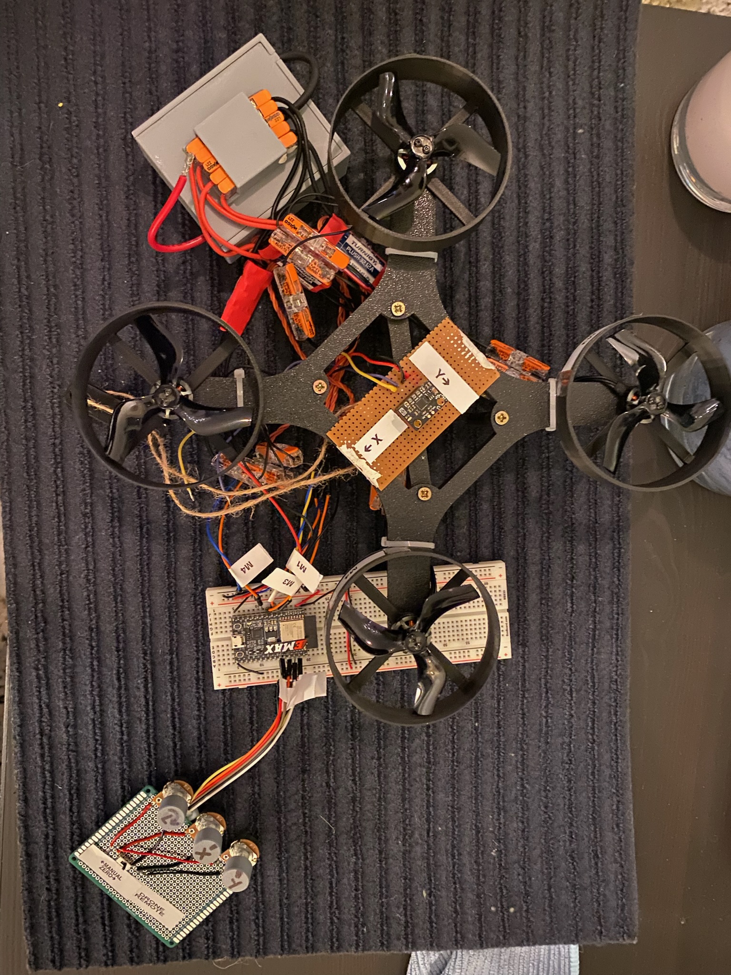
Bilder/Period 1/IMG_3497.JPG
