Siggeaxe/DIY_Quadcopter/Bilder/Period 1/IMG_3606.jpg

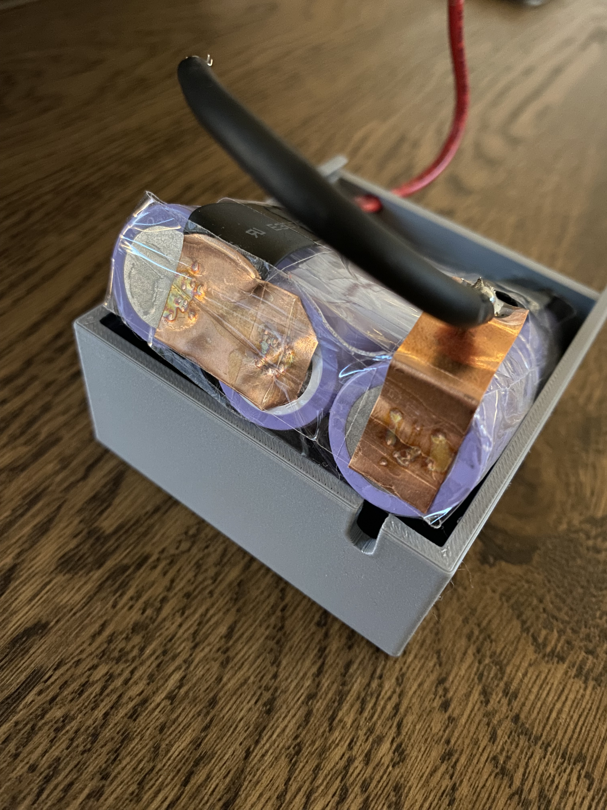
Bilder/Period 1/IMG_3606.jpg
