Siggeaxe/DIY_Quadcopter/Bilder/Period 1/Period 1 drone schematic.png

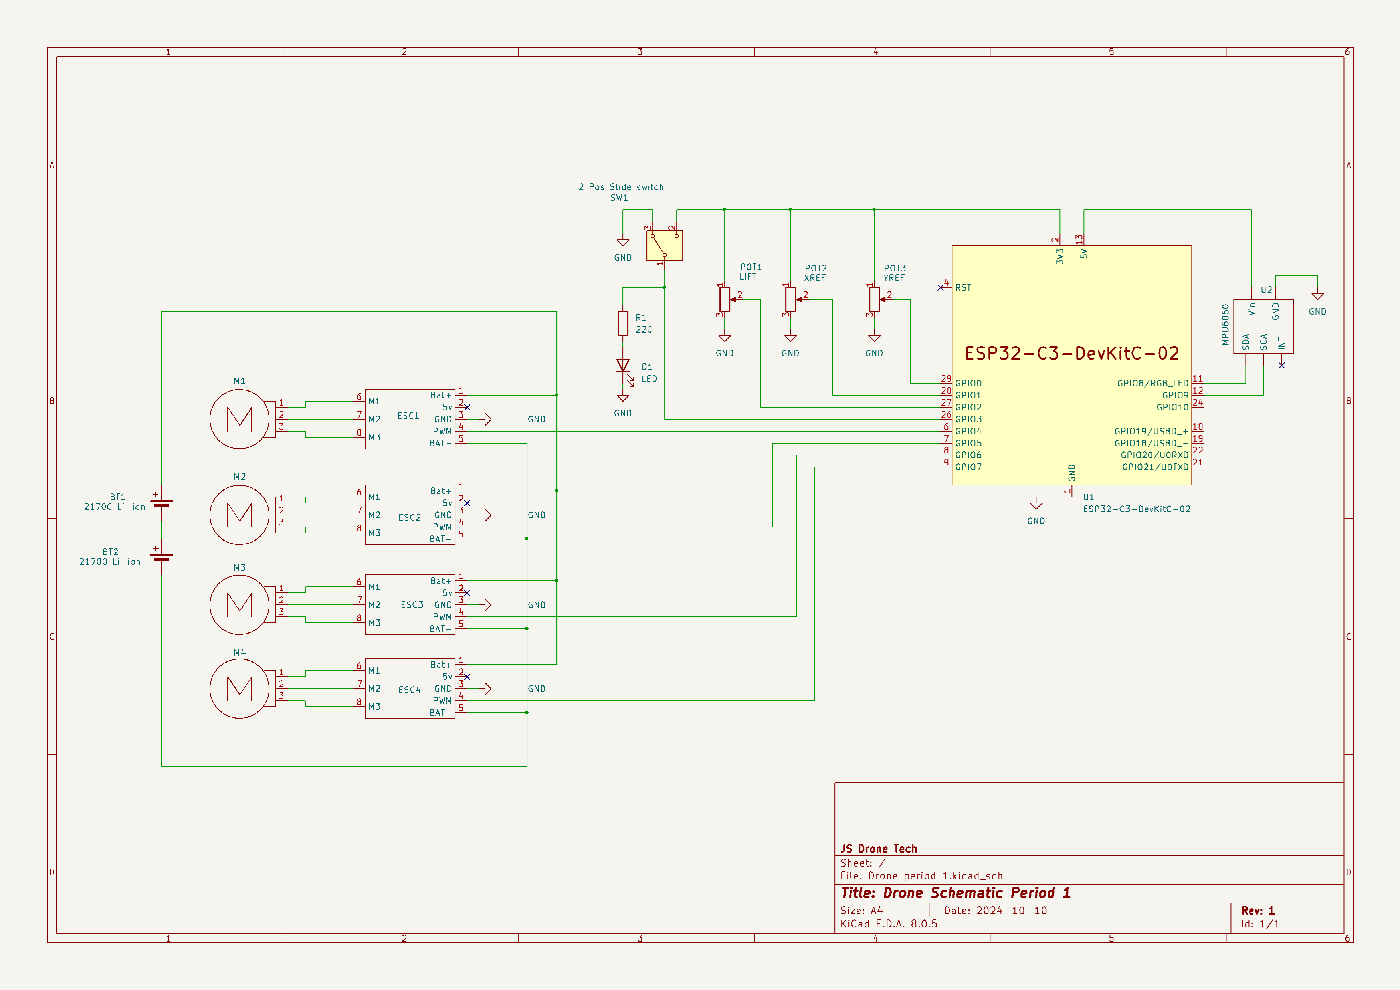
Bilder/Period 1/Period 1 drone schematic.png
