Siggeaxe/DIY_Quadcopter/Drönarkonventionen.png

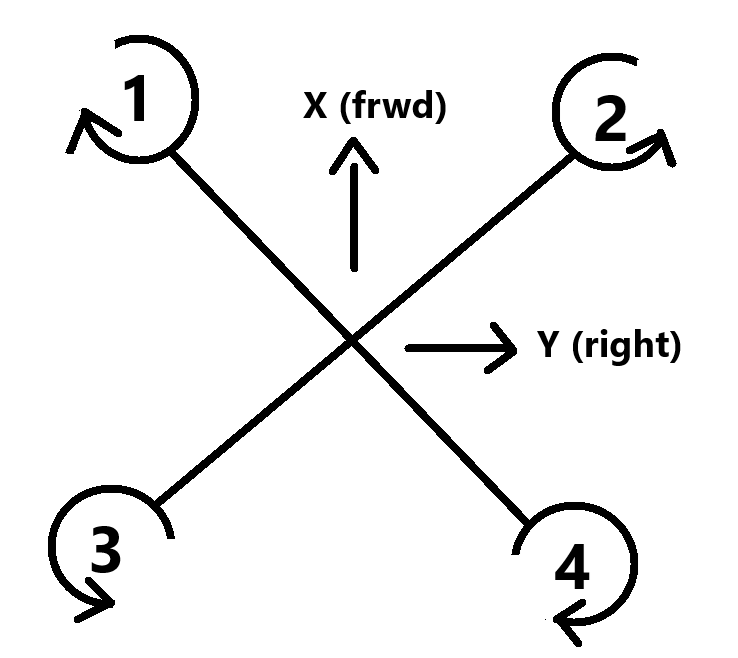
Drönarkonventionen.png
