Siggeaxe/DIY_Quadcopter/Gantt tidsplan.png

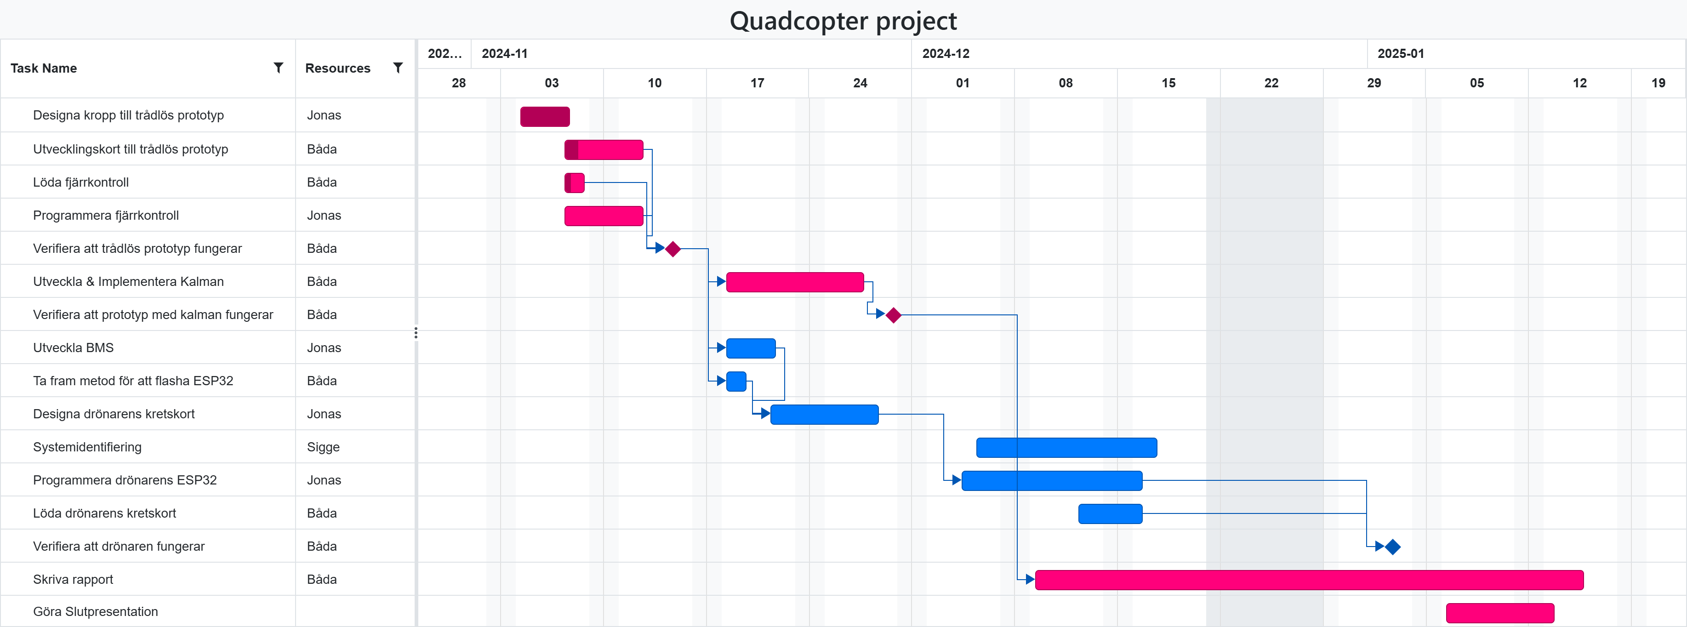
Gantt tidsplan.png
