Siggeaxe/DIY_Quadcopter/Arkiv/P1 Drone plan and BOM.xlsx

Sheet: Projektplan
Tidsplan |  | Klart | Påbörjad | Försenad
September 9-15 | September 16-22 | September 23-30 | Oktober 1-6 | Oktober 7-13 | Oktober 14-20 | Inlämning rapport 20 Okt
Vecka 37 | Vecka 38 | Vecka 39 | Vecka 40 | Vecka 41 | Vecka 42 | Vecka 43
Välja sensor | Utvärdera sensor | Implementera sensor | Montera ihop | Börja rapportskrivning | Rapportskrivning | Rapport Lämnas in
Välja motor och ESC | Utvärdera motorer & ESC | Implementera motor | Implementera regulator | Finjustering/Rest |  | Slutpresentation
Beställa ESP32 | Programmera ESP32 | Skapa och skriv ut kropp |  | Presentation framsteg
Komponentlista | Designa regulator | Första test av regulator
Projektplan | Utvärdera bluetooth (wifi) | Presentation framsteg
Presentation plan | Köpa fler motorer

Sheet: Delsystem
PART I: Rate mode
Delsystem: | Mikrokontroller | Rotation Sensor | Radio | Motorstyrning | Motor | (Batterier) | Konstruktion | Dynamik och regulator
Komponent: | ESP32 | MPU60-50 | ESP32 | ESC 40A | eco-micro-1404
Uppgifter: | Kom igång | Koppla MCU-Sensor | Datatakt | Konfigurera koppling MCU-ESC | Koppla ESC-Motor |  | Kropp - 3D printa | Enkel model dynamik - Inputs
 | IDE - Arduino/Visual Code? | Konfigurera | Räckvid | ESC Kalibrering | Mät ström |  | Testrigg? | PID
 | Hitta manual -register etc. | Communication - I2C | Strömförbrukning |  | (Mät kraft) |  |  | PID - tuning (enkel)
 | LED | Filter | Metod för att skicka data
 |  | Calibration
Carbon Aeronautics: | Projekt 1 - 2 | Projekt 4-5 | Projekt 6-8 |  |  | Projekt 3, 9 | Projekt 1, 10 | Projekt 11-13
PART II: Stabilization mode
Delsystem: | Sensorer - Kalman | Regulator
Komponent: | MPU60-50
Uppgifter: | Kalman: Gyro + Accel | Regulator för statisk stabilisering
Carbon Aeronautics: | Projekt 14-15 | Projekt 16

Sheet: Inköp
 |  |  | INKÖP
Komponent | Artikelnummer | Länk | Antal | Styckpris [sek] | Orderdatum | Utlägg
ESP32 utvecklingskort | ESP32-C3-DevKitC-02 | https://www.mouser.se/ProductDetail/Espressif-Systems/ESP32-C3-DevKitC-02?qs=stqOd1AaK7%2F1Q62ysr4CMA%3D%3D | 3 | 85 | 2024-09-11
ESC 40A | N/A | https://www.amazon.se/-/en/Brushless-Controller-Airplane-Helicopter-Quadcopter/dp/B09LYHCDP3 | 1 | 121 | 2024-09-11 | Jonas | Färgbeskrivning
Propeller | N/A | https://droneit.se/product/gemfan-2540-3-flash-propeller-2/ | 1 | 25 | 2024-09-11 |  | Mottagen order
Propeller | N/A | https://droneit.se/product/gemfan-75mm-ducted-durable-3-blade-props-75mm-3-blade-2/ | 1 | 9 | 2024-09-11 |  | Beställd
Motor | ECO14044800 | https://droneit.se/product/emax-eco-micro-1404-24s-cw/ | 1 | 189 | 2024-09-11 | Jonas | Väntar
MPU60-50 gyra/acc-sensor | SEN0142 | https://www.mouser.se/ProductDetail/DFRobot/SEN0142?qs=Zcin8yvlhnO0Rr0B1JJGiw%3D%3D | 1 | 138 | 2024-09-11 |  | Försenad
Motor | ECO14044800 | https://droneit.se/product/emax-eco-micro-1404-24s-cw/ | 3 | 189 | 2024-09-20 | Sigge
ESC 12A | 9351000122-0 | https://hobbyking.com/en_us/turnigy-plush-32-12a-2-4s-brushless-speed-controller-w-bec-rev1-1-0.html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 | 4 | 195 | 2024-09-20 | Jonas
Samsung INR21700-40T 2-pack | 41032020 | https://www.electrokit.com/batteri-li-ion-batteri-21700-3.7v-4000mah-samsung-inr21700-40t-2-pack | 1 | 249 | 2024-09-27
Batteriladdare Li-Ion | 41032016 | https://www.electrokit.com/batteriladdare-li-ion-lcd-1a-for-2x-18650-xtar-vc2 | 1 | 199 | 2024-09-27
microB kabel 1m | 41009860 | https://www.electrokit.com/usb-kabel-a-hane-micro-b-5p-hane-1m | 2 | 35 | 2024-09-27
Joystick 10k | 41003708 | https://www.electrokit.com/joystick-10k-tummanovrering | 2 | 69 | 2024-09-27
BMP280 | 41013962 | https://www.electrokit.com/temperatur-och-lufttryckssensor-pa-kort-bmp280 | 1 | 155 | 2024-09-27
40A 4000mAh cell | BAKN21700CGP | Datablad i drönar mappen | 4 | 0 | 2024-11-16
PCB Kontroller | W714032AS1C5 | PCBWay | 5 | 136 | 31 - nov |  | 18-28 är till kontrollern
Tryckknapp PCB 12x12mm - 4-pack | 41016089 | https://www.electrokit.com/tryckknapp-pcb-12x12mm-4-pack | 1 | 38 | 2024-11-08
Aktiv piezosummer 85dB 3-16VDC PCB miniatyr | 41003599 | https://www.electrokit.com/summer-4-khz-miniatyr | 1 | 29 | 2024-11-08
Hylslist 2.54mm 1x10p | 41002451 | https://www.electrokit.com/hylslist-2.54mm-1x10p | 2 | 3.75 | 2024-11-08
Hylslist 2.54mm 1x5p | 41002449 | https://www.electrokit.com/hylslist-2.54mm-1x5p | 4 | 3.1 | 2024-11-08
1206 X7R 1uF | 40503060 | https://www.electrokit.com/kondensator-1206-x7r-1uf-1025v | 10 | 2 | 2024-11-08
1206 100nF | 40503054 | https://www.electrokit.com/kondensator-1206-x7r-100nf-10 | 10 | 1 | 2024-11-08
Skjutomkopplare 1-pol on-on pcb vinklad | 41011898 | https://www.electrokit.com/skjutomkopplare-1-pol-on-on-pcb-vinklad | 2 | 19 | 2024-11-08
10kohm SMD 1206 | 40818410 | https://www.electrokit.com/motstand-10kohm-0.25w-smd-1206 | 20 | 1 | 2024-11-08
390ohm SMD 1206 | 40818239 | https://www.electrokit.com/motstand-390ohm-0.25w-smd-1206 | 10 | 1 | 2024-11-08
100ohm SMD 1206 | 40818210 | https://www.electrokit.com/motstand-100ohm-0.25w-smd-1206 | 10 | 1 | 2024-11-08
MPU-6050 accelerometer 3-axel & gyro monterad på kort | 41016233 | https://www.electrokit.com/mpu-6050-accelerometer-3-axel-gyro-monterad-pa-kort | 1 | 52 | 2024-11-11
 |  |  | Totalkostnad [sek] | Universitetet | Utlägg Jonas | Utlägg Sigge
 |  |  | 3821.9 | 2164.9 | 1090 | 567
