Siggeaxe/DIY_Quadcopter/Bilder/Period 1/Drone components.png

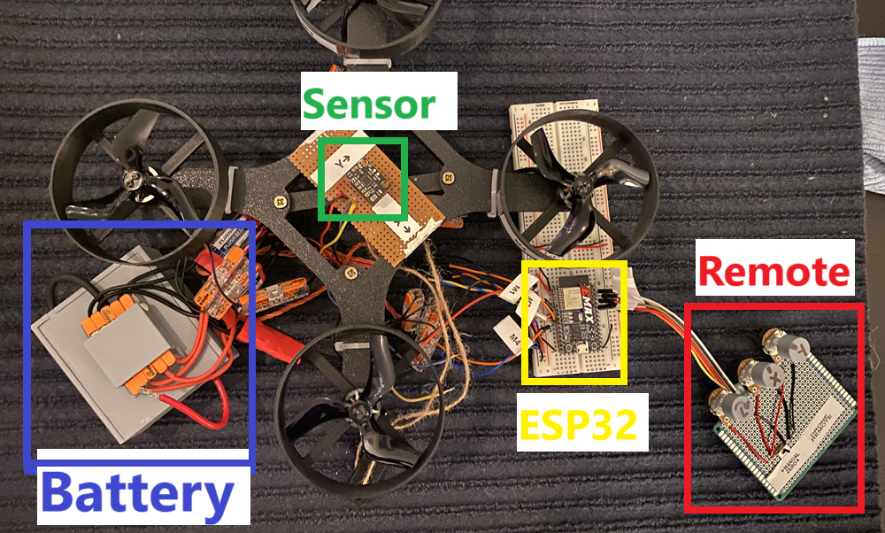
Bilder/Period 1/Drone components.png
