Siggeaxe/DIY_Quadcopter/KiCad/Remote/Remote.kicad_pcb

## KiCad design KiCad/Remote/Remote.kicad_pcb (2024-11-19)

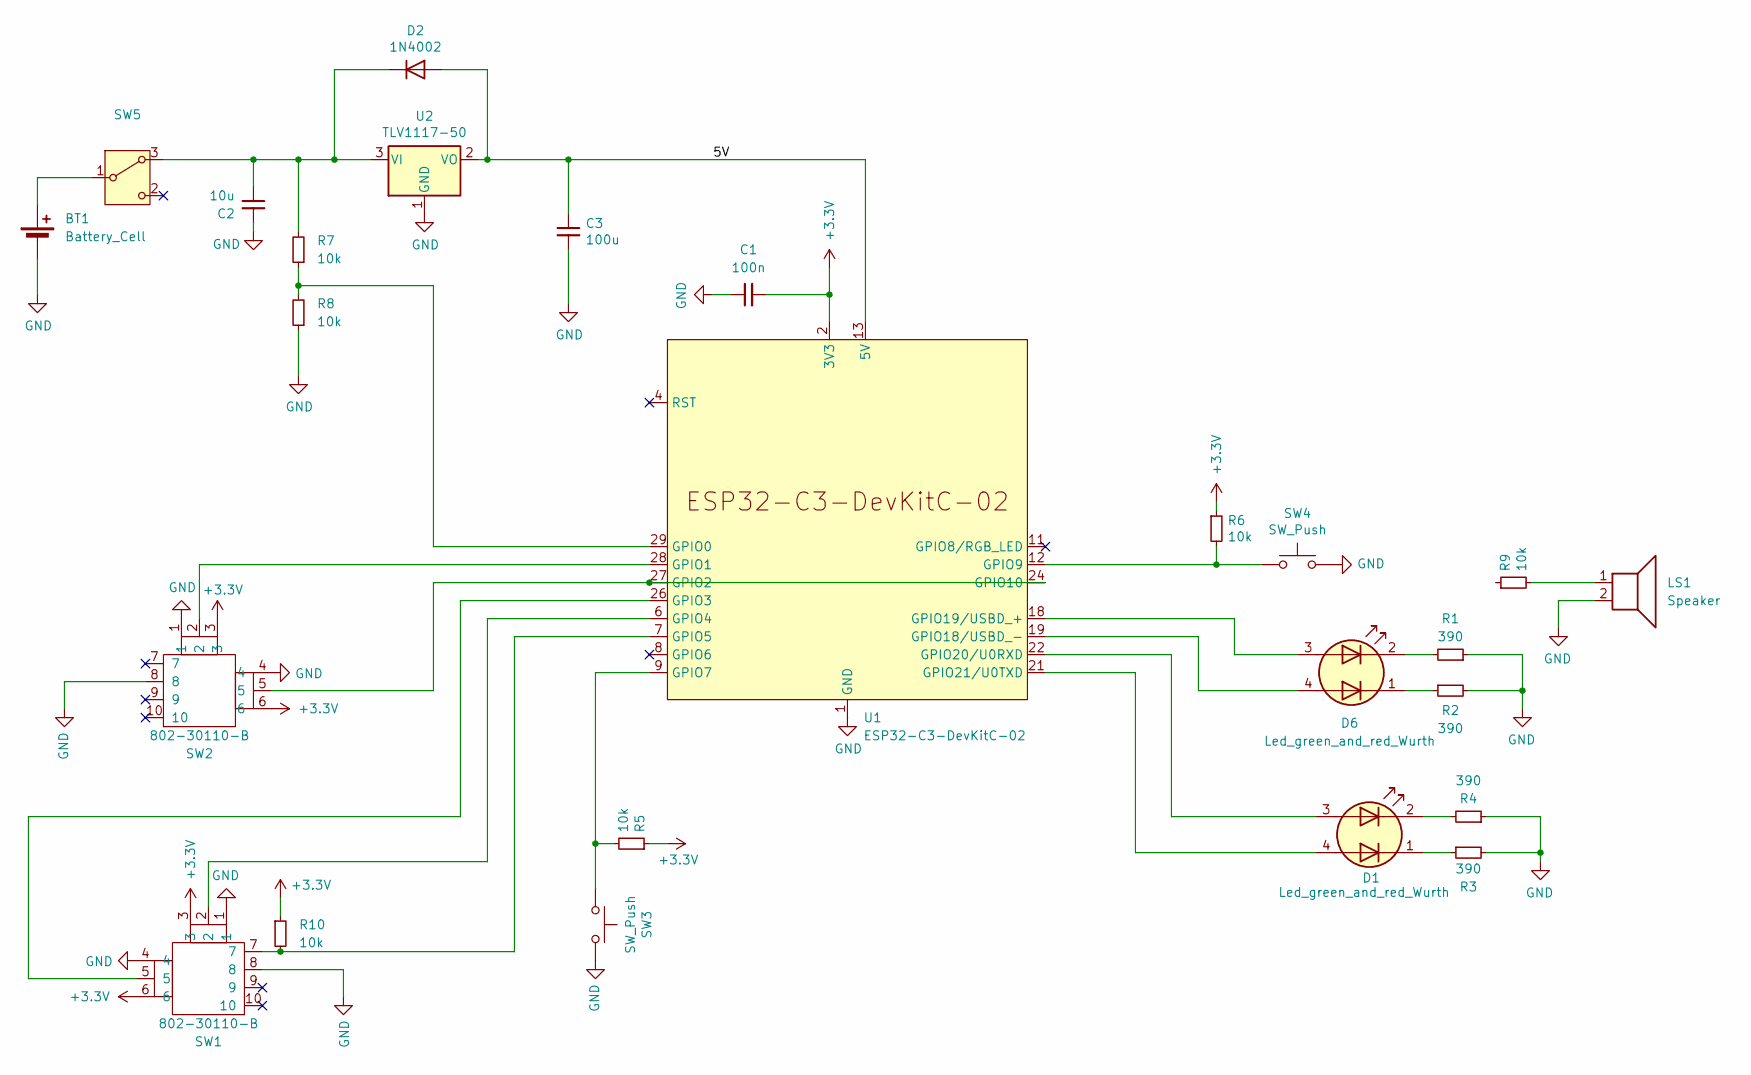
[picture p42: schematic Remote.kicad_sch]

Parts:
BT1: Battery_Cell; 9v bat holder
C1: 100n; C_0805_2012Metric_Pad1.18x1.45mm_HandSolder
C2: 10u; C_0805_2012Metric_Pad1.18x1.45mm_HandSolder
C3: 100u; C_0805_2012Metric_Pad1.18x1.45mm_HandSolder
D1, D6: Led_green_and_red_Wurth; Led green and red Wurth
D2: 1N4002; D_0805_2012Metric_Pad1.15x1.40mm_HandSolder
LS1: Speaker; summer 4khz miniatyr
R1, R2, R3, R4: 390; R_0805_2012Metric_Pad1.20x1.40mm_HandSolder
R5, R6, R7, R8, R9, R10: 10k; R_0805_2012Metric_Pad1.20x1.40mm_HandSolder
SW1, SW2: 802-30110-B; Joystick
SW3, SW4: SW_Push; SW_PUSH-12mm
SW5: Skjutomkopplare 1-pol on-on pcb vinklad
U1: ESP32-C3-DevKitC-02
U2: TLV1117-50; SOT230P700X180-4N

Connections:
5V: C3.1, D2.2 (A), U1.13 (5V), U1.14 (5V), U2.2 (VO)
+3.3V: C1.2, R5.1, R6.1, R10.1, SW1.3, SW1.6, SW2.3, SW2.6, U1.2 (3V3), U1.3 (3V3)
GND: BT1.2 (-), C1.1, C2.2, C3.2, LS1.2, R1.1, R2.2, R3.2, R4.1, R8.1, SW1.1, SW1.4, SW1.8, SW2.1, SW2.4, SW2.8, SW3.2, SW4.2, U1.1 (GND), U1.5 (GND), U1.10 (GND), U1.15 (GND), U1.16 (GND), U1.17 (GND), U1.20 (GND), U1.23 (GND), U1.25 (GND), U1.30 (GND), U2.1 (GND)
unnamed: BT1.1 (+), SW5.1 (B)
unnamed: D1.3 (A1), U1.22 (GPIO20/U0RXD)
unnamed: D1.4 (A2), U1.21 (GPIO21/U0TXD)
unnamed: D1.2 (K1), R4.2
unnamed: D1.1 (K2), R3.1
unnamed: C2.1, D2.1 (K), R7.2, SW5.3 (A), U2.3 (VI)
unnamed: D6.3 (A1), U1.18 (GPIO19/USBD_+)
unnamed: D6.4 (A2), U1.19 (GPIO18/USBD_-)
unnamed: D6.2 (K1), R1.2
unnamed: D6.1 (K2), R2.1
unnamed: LS1.1, R9.2
unnamed: R7.1, R8.2, U1.29 (GPIO0)
unnamed: SW2.2, U1.28 (GPIO1)
unnamed: SW1.5, U1.26 (GPIO3)
unnamed: SW1.2, U1.6 (GPIO4)
unnamed: R10.2, SW1.7, U1.7 (GPIO5)
unnamed: R5.2, SW3.1, U1.9 (GPIO7)
unnamed: R6.2, SW4.1, U1.12 (GPIO9)

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
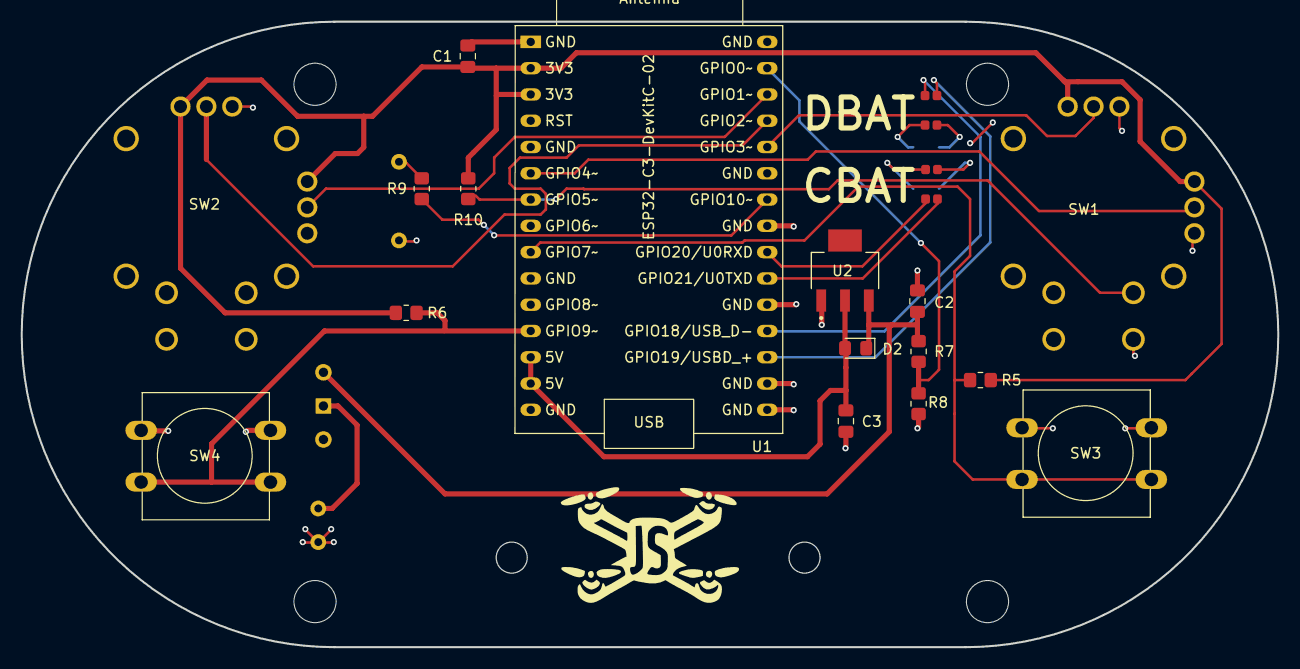
[picture p43: board Remote.kicad_pcb from above]

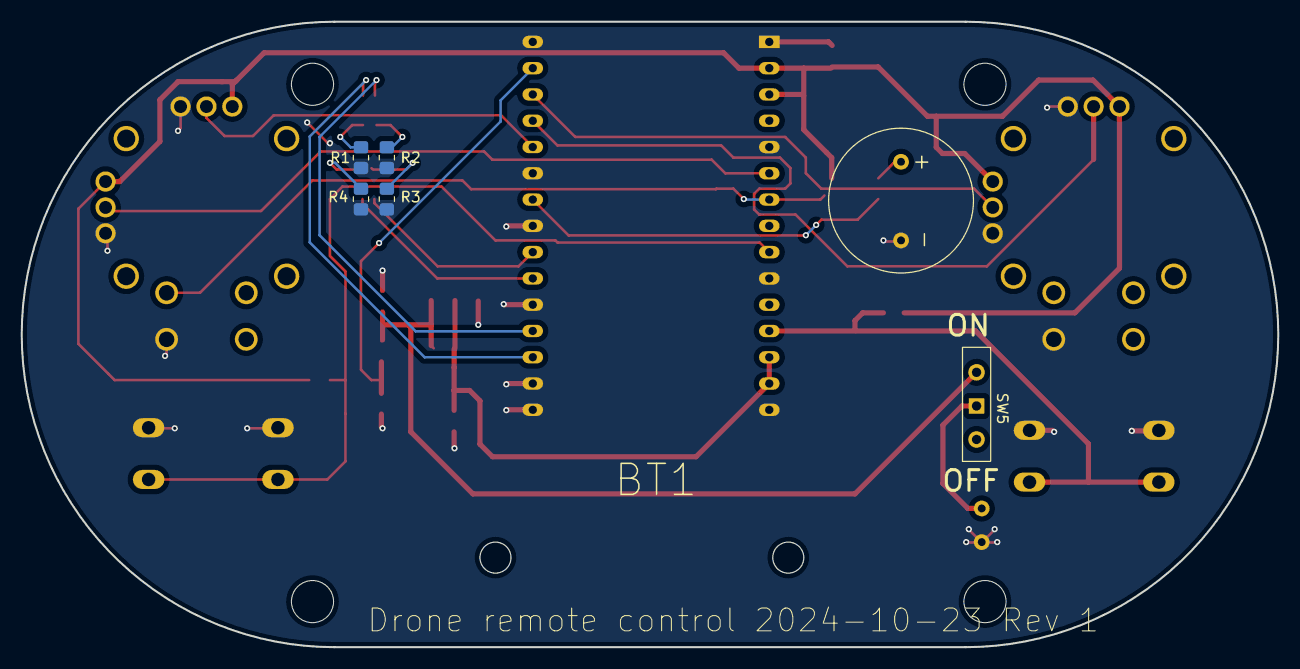
[picture p44: board Remote.kicad_pcb from below]

Board: 2 copper layers, 121.5 x 60.5 mm, 25 parts (7 on the bottom side), 23 nets.
