Siggeaxe/DIY_Quadcopter/Arduino program/Period 1/wifi_Broadcast_Master/wifi_Broadcast_Master.ino

/*
    ESP-NOW Broadcast Master
    Lucas Saavedra Vaz - 2024

    This sketch demonstrates how to broadcast messages to all devices within the ESP-NOW network.
    This example is intended to be used with the ESP-NOW Broadcast Slave example.

    The master device will broadcast a message every 5 seconds to all devices within the network.
    This will be done using by registering a peer object with the broadcast address.

    The slave devices will receive the broadcasted messages and print them to the Serial Monitor.
*/

#include "ESP32_NOW.h"
#include "WiFi.h"

#include <esp_mac.h>  // For the MAC2STR and MACSTR macros

/* Definitions */

#define ESPNOW_WIFI_CHANNEL 6

/* Classes */

// Creating a new class that inherits from the ESP_NOW_Peer class is required.

class ESP_NOW_Broadcast_Peer : public ESP_NOW_Peer {
public:
  // Constructor of the class using the broadcast address
  ESP_NOW_Broadcast_Peer(uint8_t channel, wifi_interface_t iface, const uint8_t *lmk) : ESP_NOW_Peer(ESP_NOW.BROADCAST_ADDR, channel, iface, lmk) {}

  // Destructor of the class
  ~ESP_NOW_Broadcast_Peer() {
    remove();
  }

  // Function to properly initialize the ESP-NOW and register the broadcast peer
  bool begin() {
    if (!ESP_NOW.begin() || !add()) {
      log_e("Failed to initialize ESP-NOW or register the broadcast peer");
      return false;
    }
    return true;
  }

  // Function to send a message to all devices within the network
  bool send_message(const uint8_t *data, size_t len) {
    if (!send(data, len)) {
      log_e("Failed to broadcast message");
      return false;
    }
    return true;
  }
};

/* Global Variables */

uint32_t msg_count = 0;

// Create a broadcast peer object
ESP_NOW_Broadcast_Peer broadcast_peer(ESPNOW_WIFI_CHANNEL, WIFI_IF_STA, NULL);

/* Main */

void setup() {
  Serial.begin(115200);
  while (!Serial) {
    delay(10);
  }

  // Initialize the Wi-Fi module
  WiFi.mode(WIFI_STA);
  WiFi.setChannel(ESPNOW_WIFI_CHANNEL);
  while (!WiFi.STA.started()) {
    delay(100);
  }

  Serial.println("ESP-NOW Example - Broadcast Master");
  Serial.println("Wi-Fi parameters:");
  Serial.println("  Mode: STA");
  Serial.println("  MAC Address: " + WiFi.macAddress());
  Serial.printf("  Channel: %d\n", ESPNOW_WIFI_CHANNEL);

  // Register the broadcast peer
  if (!broadcast_peer.begin()) {
    Serial.println("Failed to initialize broadcast peer");
    Serial.println("Reebooting in 5 seconds...");
    delay(5000);
    ESP.restart();
  }

  Serial.println("Setup complete. Broadcasting messages every 5 seconds.");
}

void loop() {
  // Broadcast a number instead of a string
  int V_A1 = analogRead(1);
  uint8_t data = V_A1 >> 4; //Throw away 4 lsb so that adc reading is 8 bit

  // Use %u to print unsigned integers
  Serial.printf("Broadcasting message: %u\n", data);

  // Send the number as raw data
  if (!broadcast_peer.send_message((uint8_t *)&data, sizeof(data))) {
    Serial.println("Failed to broadcast message");
  }

  delay(100);
}
