Siggeaxe/DIY_Quadcopter/Arduino program/Period 1/Arkiv/BLE_test_server/BLE_test_server.ino

#include <BLEDevice.h>
#include <BLEUtils.h>
#include <BLEServer.h>

#define SERVICE_UUID        "4fafc201-1fb5-459e-8fcc-c5c9c331914b"
#define CHARACTERISTIC_UUID "beb5483e-36e1-4688-b7f5-ea07361b26a8"

// Create a BLE characteristic globally to update in loop
BLECharacteristic *pCharacteristic;

void setup() {
  Serial.begin(115200);
  Serial.println("Starting BLE Server!");

  BLEDevice::init("Jonas esp server");
  BLEServer *pServer = BLEDevice::createServer();
  BLEService *pService = pServer->createService(SERVICE_UUID);
  
  pCharacteristic = pService->createCharacteristic(
    CHARACTERISTIC_UUID,
    BLECharacteristic::PROPERTY_READ | BLECharacteristic::PROPERTY_WRITE
  );

  // Set initial value
  pCharacteristic->setValue("Hello World from Server");
  pService->start();
  
  // Start advertising
  BLEAdvertising *pAdvertising = BLEDevice::getAdvertising();
  pAdvertising->addServiceUUID(SERVICE_UUID);
  pAdvertising->setScanResponse(true);
  pAdvertising->setMinPreferred(0x06);  // for iPhone compatibility
  pAdvertising->setMinPreferred(0x12);
  BLEDevice::startAdvertising();
  Serial.println("Characteristic defined! Now you can read/write from client.");
}

void loop() {
  // Optionally update the characteristic value periodically
  pCharacteristic->setValue("Hello World from Server");
  delay(2000);  // Send every 2 seconds
}
