Siggeaxe/DIY_Quadcopter/Bilder/Period 2/IMG_3621.jpg

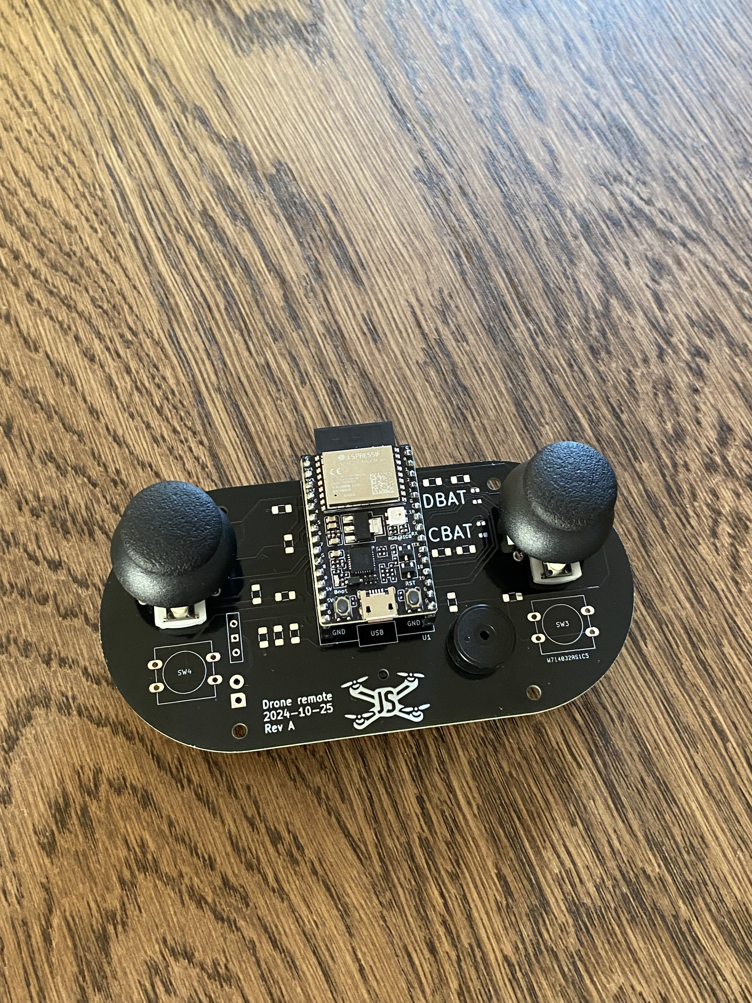
[picture p1: Bilder/Period 2/IMG_3621.jpg]
Bilder/Period 2/IMG_3621.jpg
