Siggeaxe/DIY_Quadcopter/Bilder/Period 2/IMG_3623.jpg

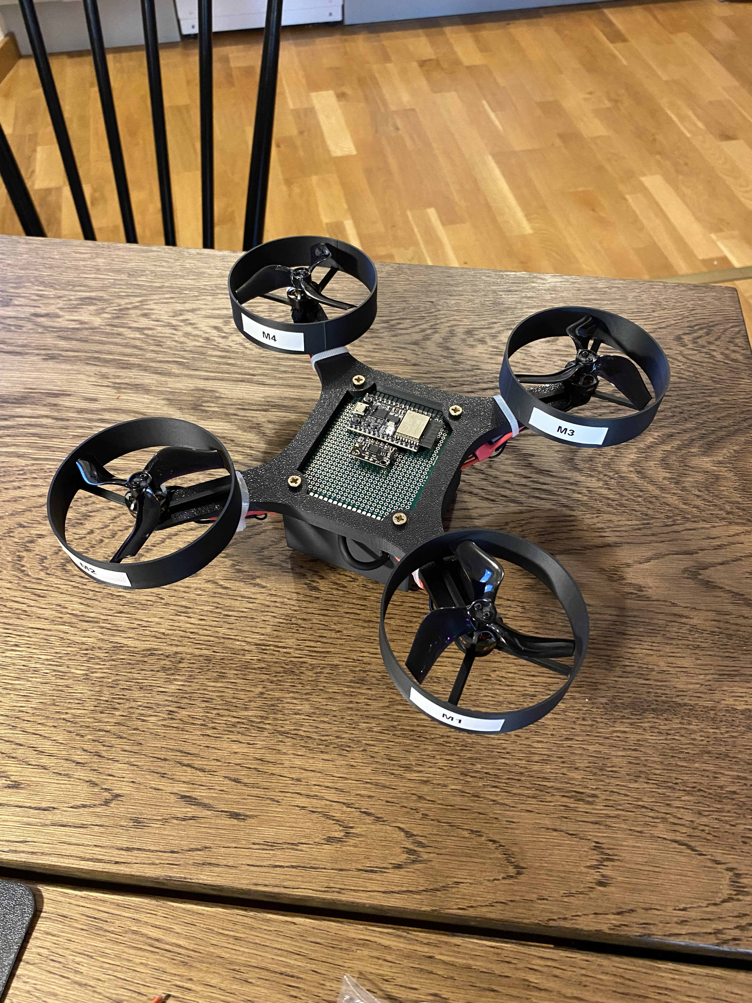
[picture p2: Bilder/Period 2/IMG_3623.jpg]
Bilder/Period 2/IMG_3623.jpg
